z80/supply/main-board/software/pawn/doc/images/supply.png

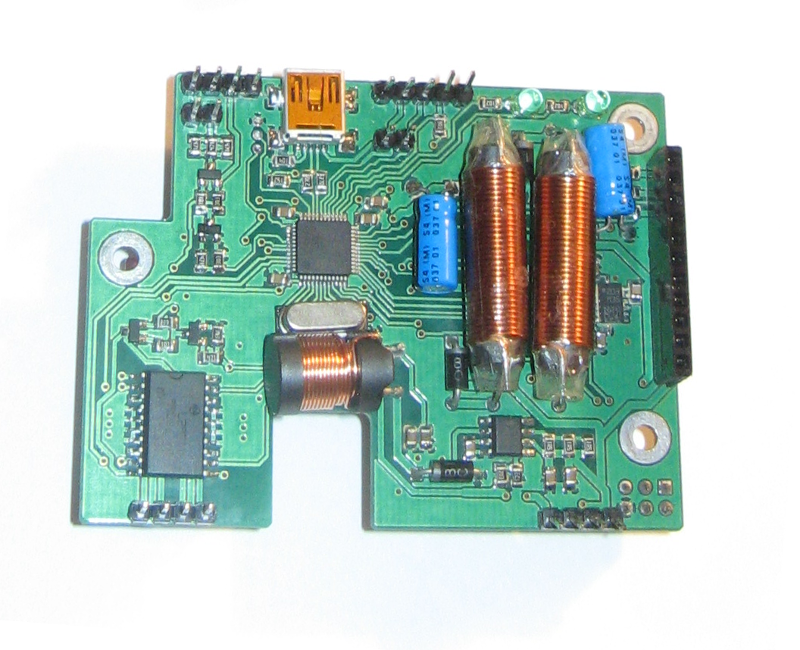
main-board/software/pawn/doc/images/supply.png
