z80/supply/docs/movie_plan.odt

Movie plan.

1. Standalone board introduction.
  1. Overall view.
  2. Explain feature with scripting.
  3. Explain it can work standalone, with computer connected and with RPi connected. Emphasize that it is step to the future detailed explanation. Probably show a stack with RPi and emphasize that it can not only execute it's commands but provide RPi with regulated power. Explain about RPi form factor and cutouts necessary on the board and RPi sockets for which those cutouts are made.
  4. List board interfaces.
    1. USB 1.4.2. Serial. 1.4.3. I2C bus master interface.
    2. I2C slave device. And these two are different and totally independent.
  5. List board peripherials.
    1. High speed microcontroller capable to run up to 72MHz.
    2. 3 voltage converters. Emphasize: these are converters – not regulators. E.i. efficiency is very high. It is proven: board is cold at currents up to 3A.
      1. Constant for 3.3V for feeding internals and has output to provide with stabilized current externally connected devices (if any).
      2. Fully controllable step down converter.
        1. On/off.
        2. Output voltage.
        3. Input current.
      3. Fully controllable step up converter.
        1. On/off.
        2. Output voltage.
        3. Input current.
        4. Minimum input voltage. Important for solar panels.

1.5.3. Motor controller with protective diodes. 4 half bridges. Capable to drive 4 unidirectional DC, 2 bidirectional DC or stepper motor. 600mA continuous current, 1200mA short time current.

1.5.4. LED driver circuit for powering illuminating LED with current of about 100mA.

1.5.5. Analog thermometer with range from -40C to 125C.

1.5.6. Digital accelerometer.

1.5.7. Digital compass.

1.5.8. Digital thermometer.

1.5.9. Trigger button port. Board can change it's behavior in accordance with button clicks.

1.5.10. Power output port. At this port there are all voltages available.

2. Extension boards. If base board functionality isn't enough. One or a few addon boards could be stacked on primary board.

2.1. Content of addon board.

2.1.1. 8 PWM servo compatible output ports. Show servo test in action.

2.1.2. 8 motor controller outputs. Suitable for 8 inidirectional DC motors, 4 bidirectional or 2 stepper motors control.

2.1.3. 8 digital inputs. Like user buttons or digital (on/off state) sensors control.

2.1.4. 8 analog ADC inputs with range from 0V to 3.3V.

2.2. Emphasize that functionality could be multiplied by adding as many addon boards as necessary.

2.3. Demonstrate stacking of a few addon boards on a primary one.

3. Powering the board.

3.1. Powering though step down input. Voltage should be not smaller then 3.3V.

3.2. Powering through step up input. Board can increase input voltage first.

3.3. Powering through USB port. It is the same as through step up port. But here is hardware current limiting circuit. And a switch which actually conducts current from USB socket to board internals.

4. Connecting with a computer.

4.1. Connection through USB socket. Show a connection and explain that it can get power from USB bus. But if high current applications is required a battery is required. Advantage is that the board can charge the battery taring power from USB and increasing voltage using step up configurable converter.

4.2. Connection through RPi extension socket. Explain that in this case communication goes through I2C bus. For the board it is I2C slave mode.

5. Board programming.

5.1. Introduce scripting approach. Emphasize that the board can work alone without a computer. It event can turn computer on and off and can be a power supply for an RPi computer.

5.2. Show an example of blinky script.

5.3. Explain 128kB FLASH and 20kB RAM. But didn't ever occupy more then 2kB FLASH by the moment.

5.3. Script compilation.

5.4. Script upload to the board.

5.5. Script execution and 5 sec delay for an ability to reprogram the board in the case of a fail script.

5.6. Explain board communication. No difference between USB and I2C from the point of view to the interface.

5.7. If coupled with a computer script is in charge for commands interpreting on board side. And user program on the other side.

5.8. Python modules and C++ library with totally identical API for programming communication between the board and a computer.

6. Example board to computer communication.

6.1. Show installation assembling of the board, addon board, two servos and a camera.

6.2. Demonstrate rotatable Web camera example video.

7. Example RPi with the board.

7.1. Show stack assembling.

7.2. Explain the ability of the board to be Rpi power supply and turn it on by a schedule or by button click.

7.3. Assemble an installation with chassis and camera.

7.4. Demonstrate robot video.

7. Example pure RPi power supply.

7.4. Assemble stack and explain where power comes from.

7.5. Attach user button and explain the feature with powering on.

7.6. Show in video how it works.
