z80/supply/main-board/software/pawn/doc/images/2_addons_on_supply_on_pi.png

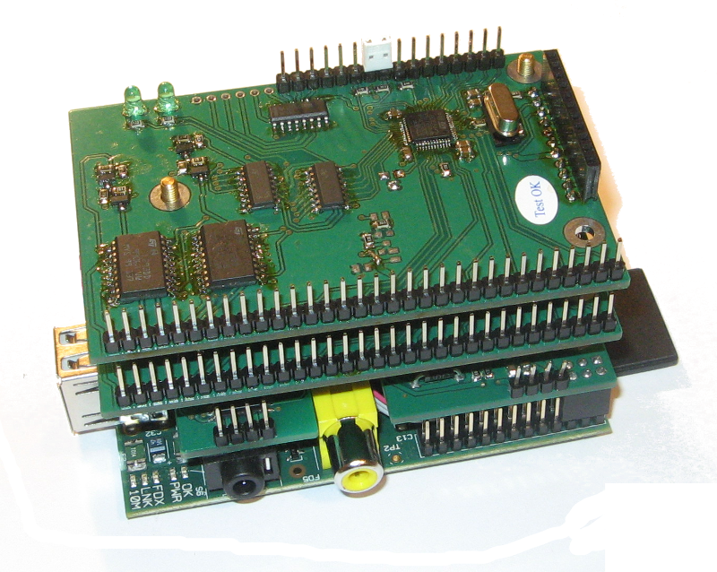
main-board/software/pawn/doc/images/2_addons_on_supply_on_pi.png
