z80/supply/main-board/software/pawn/doc/images/addon.png

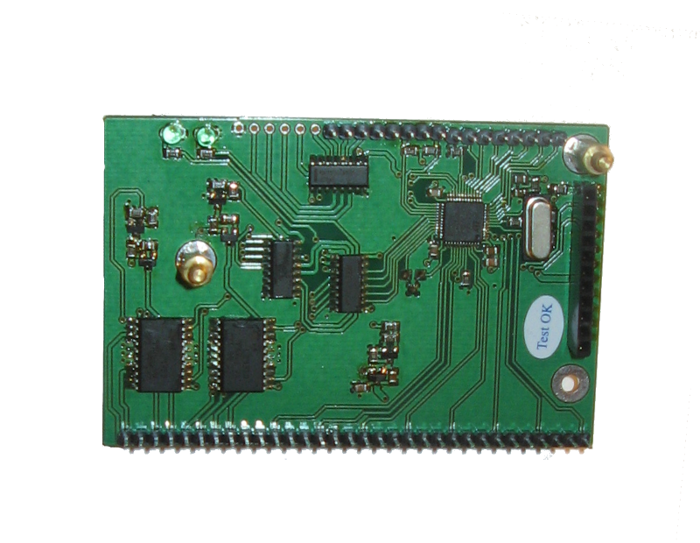
main-board/software/pawn/doc/images/addon.png
