z80/supply/main-board/software/pawn/doc/images/addon_desc.png

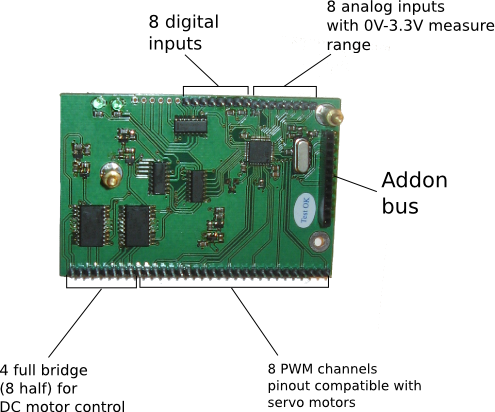
main-board/software/pawn/doc/images/addon_desc.png
