z80/supply/main-board/software/pawn/doc/images/addon_on_supply_on_pi.png

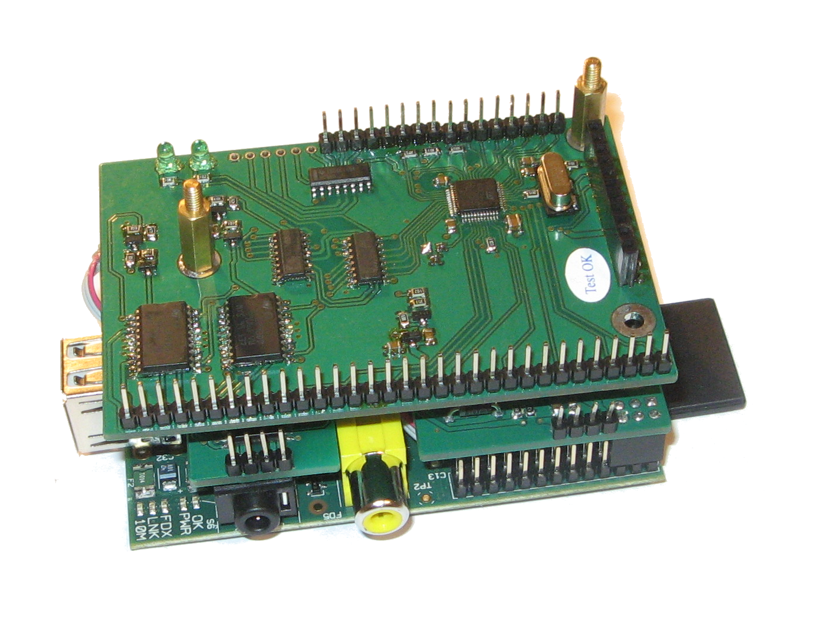
main-board/software/pawn/doc/images/addon_on_supply_on_pi.png
