z80/supply/main-board/software/pawn/doc/images/gui.png

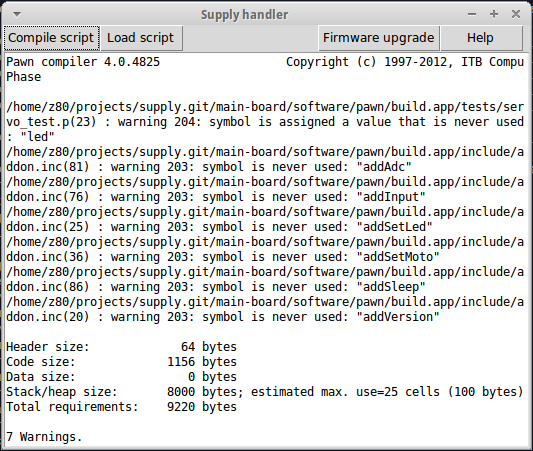
main-board/software/pawn/doc/images/gui.png
