z80/supply/main-board/software/pawn/doc/images/supply_desc.png

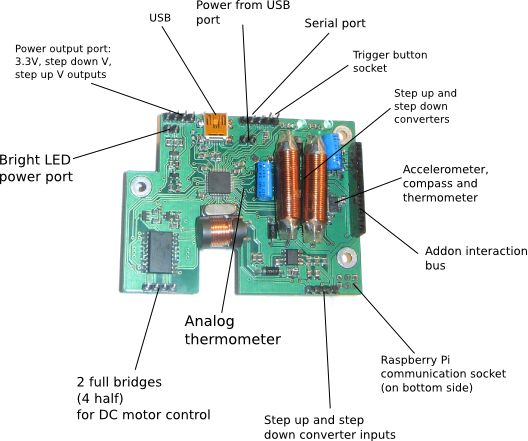
main-board/software/pawn/doc/images/supply_desc.png
