z80/supply/main-board/software/pawn/doc/images/supply_on_pi.png

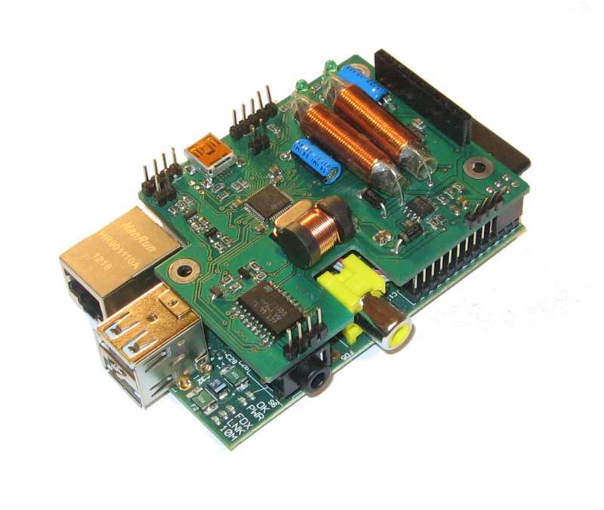
main-board/software/pawn/doc/images/supply_on_pi.png
