z80/supply/docs/bom.ods

Sheet: supply
Description, package | id | cnt | price
mcu, tqfp48 | stm32f103c8t6 | 1 | 200
quartz, 8MHz |  | 1 | 30
schotkey | 1n5819 | 3
opamp | ad8607
inductance for mcu, sumida | RCH114NP-101KB | 1
inductance for bust, buck |  | 2
accelerometer/compass, lga14 | lsm303dlhc | 1
Mosfet-P, sot23 | IRLML2244 | 2
Mosfet-p, sot223 | IRLML2244 | 1
Mosfet-N, sot223 | IRLML2502 | 1
tc1047A, temperature sensor, sot23 |  | 1
ncp3063 |  | 1
L293D driver |  | 1
mini USB-B |  | 1

Sheet: addon
Description, package | id | cnt | price
Posfet-P, sot23 | IRLML2244 | 3
stm32, lqft48 |  | 1
quartz, 8MHz |  | 1
L293D |  | 2
74HC595 |  | 2
74HC165 |  | 1
