z80/supply/(list of files, cad)

Other CAD files:
main-board-2/firmware/chibios/demos/STM8L-STM8L152-DISCOVERY-STVD/cosmic/cosmic.stp
main-board-2/firmware/chibios/demos/STM8L-STM8L152-DISCOVERY-STVD/raisonance/raisonance.stp
main-board-2/firmware/chibios/demos/STM8S-STM8S105-DISCOVERY-STVD/cosmic/cosmic.stp
main-board-2/firmware/chibios/demos/STM8S-STM8S105-DISCOVERY-STVD/raisonance/raisonance.stp
main-board-2/firmware/chibios/testhal/STM8S/SPI/cosmic/cosmic.stp
main-board-2/firmware/chibios/testhal/STM8S/SPI/raisonance/raisonance.stp
