z80/supply/docs/todo.odt

Found errors.

1. Main board: solar input comes directly to boost circuit without passing OpAmp. E.i. charging current is not measured at the moment.

2. USB power goes to nowhere as “boost+” network is not connected to anything. But it goes through OpAmp and measured.

3. Capacitors must be at least 1000uF to prevent Raspberry and WiFi from hanging up. Event with such capacitors the system hangs up after attempt to work with servos. So it is necessary to filter servo power consumption.

4. Inductors (to the right) and capacitors (up) must be shifter in order to free enough room for 1000uF capacitors.

5. Some sort of current limiting circuit MUST be implemented as 1000uF capacitors are used for power filtering. Now made it as a little separate board.

6. Make at least 2 buck inputs, 2 boost inputs and 4 ground. It is because designed current limit per pin is 1A but system consumption is much more.

7. Make holes for cross board sockets CSLS compatible.

8. Displace accelerometer and electrolytic capacitors to leave some room for LEDs. As now they overlap.

9. Rotate LED power socket 90 degrees to the right.

10. Make normal programming sockets. E.i. Attachable with step size 2.54mm.

11. Make power and motor sockets “klemma” sockets!!! This is absolutely necessary!

12. One more power socket (at least holes for delivering power) on addon board.

13. Ability to FLASH addon board using serial bootloader. E.i. BOOT0 to 3.3V jumper or holes for that jumper. And explicitly show three pins for attaching serial cable to.

14. Make I2C address savable to FLASH memory on addon boards. Add command to set new I2C adress respectively.

To do list related to regular firmware.

1. ~~Split build into two projects with common source folder but different config files.~~

2. ~~Make USB support and clock frequency different in these projects.~~

3. ~~Implement buck/boost converters with current limiting and boost power source lower voltage limit.~~

5. ~~Implement temperature, voltages and currents measure.~~

6. ~~Implement LED controls.~~

7. ~~Implement motor controls.~~

6. ~~Implement low power modes.~~ It is implemented by default in chibios.

7. ~~Implement Pawn machine with uint8_t state array accessible with both USB and I2C slave.~~

7.1. ~~Add converter parameters setup, all measures (I, V, T) to Pawn.~~

~~7.2. Make Pawn header file with native functions list.~~

7.3. Adjust library responsible for USB communication. It should write compiled Pawn script with maximum speed. It should have access to Pawn state array. And it should be able to do the same through I2C slave.

7.4. Make Pawn compilation support, make some sort of command line..... (may be, don't know yet).

8. ~~Implement I2C master with RAW functionality. E.i. write and read.~~

9. Make GUI for firmware upgrade and Pawn compilation.

10. Implement interface library support in Python (??? may be).

11. ~~Implement UART support.~~

12. Implement UART support in Pawn.

13. Add UART support to Pawn native functions header file.

To do list related to firmware for addon board.

1. Implement buffers support.

2. Implement power outs support.

3. Implement digital inputs support.

4. Implement ADC support.

5. Implement I2C slave support.

6. Implement 1....4 functionality invocation in I2C slave.

Found errors.

1. “+6V” and “batt+” should be connected. But they are not!

2. Make optional servo charge through resistor to prevent servo jumps at power up.

3. Make P-mosfet on/off as it is now but without any slow start because it turned out to not working as expected! Anyway current is much higher then desired.

4. Servos hang up Raspberry. It must be it is due to high current consumption. It might be it would be nice to place an inductor there to filter incoming voltage. It doesn't help.

5. Make all sockets to stay close to board edge.
