z80/supply/addon-acc/electric/scheme/addon-acc.kicad_pcb

## KiCad design addon-acc/electric/scheme/addon-acc.kicad_pcb (2013-12-23)

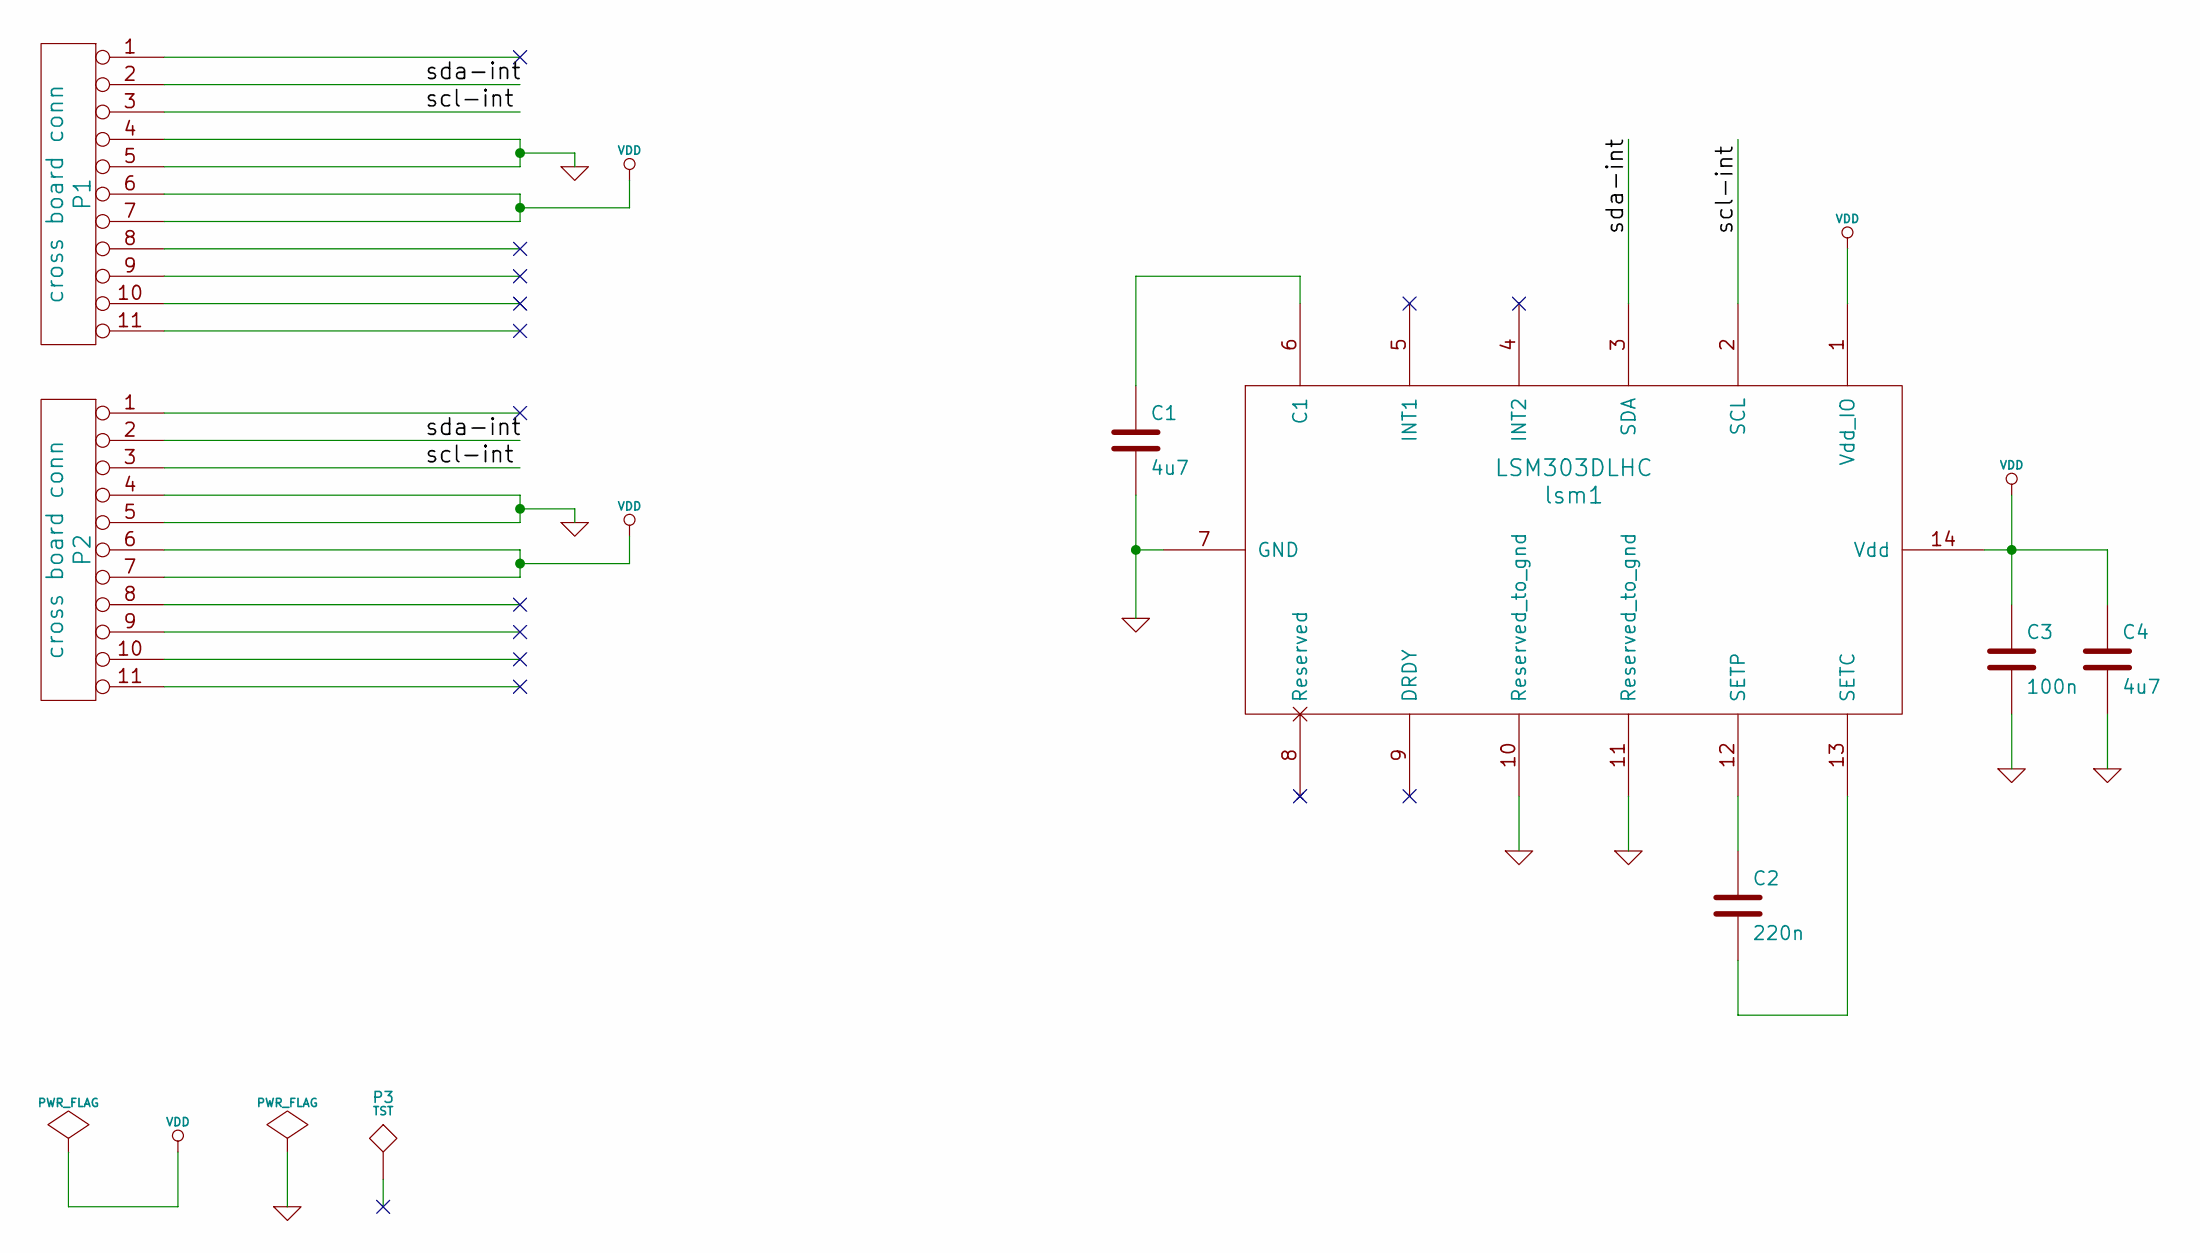
[picture p13: schematic addon-acc.sch]

Parts:
C1, C4: 4u7
C2: 220n
C3: 100n
P1, P2: cross board conn
P3: TST
lsm1: LSM303DLHC

Connections:
/scl-int: P1.3, P2.3, lsm1.2 (SCL)
/sda-int: P1.2, P2.2, lsm1.3 (SDA)
GND: C1.2, C3.2, C4.2, P1.4, P1.5, P2.4, P2.5, lsm1.7 (GND), lsm1.10 (Reserved_to_gnd), lsm1.11 (Reserved_to_gnd)
unnamed: C2.1, lsm1.12 (SETP)
unnamed: C1.1, lsm1.6 (C1)
unnamed: C2.2, lsm1.13 (SETC)
VDD: C3.1, C4.1, P1.6, P1.7, P2.6, P2.7, lsm1.1 (Vdd_IO), lsm1.14 (Vdd)

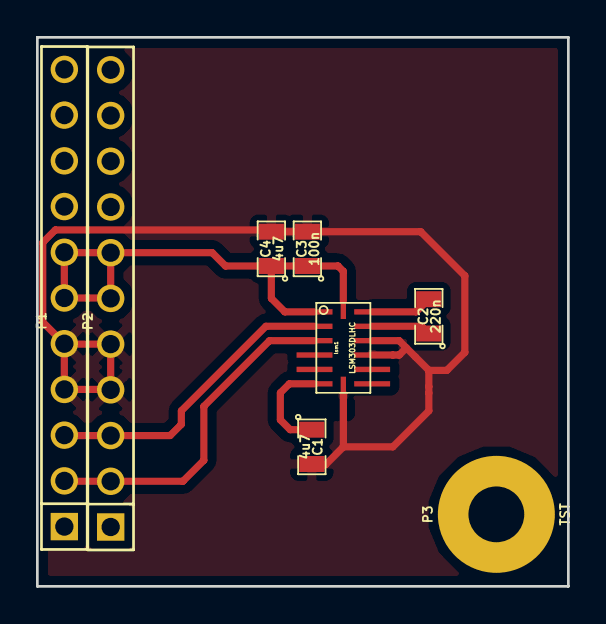
[picture p14: board addon-acc.kicad_pcb from above]

Board: 2 copper layers, 29.5 x 30.5 mm, 8 parts (0 on the bottom side), 7 nets.
