z80/supply/addon-gpio/electric/scheme/addon-gpio.kicad_pcb

## KiCad design addon-gpio/electric/scheme/addon-gpio.kicad_pcb (2013-12-23)

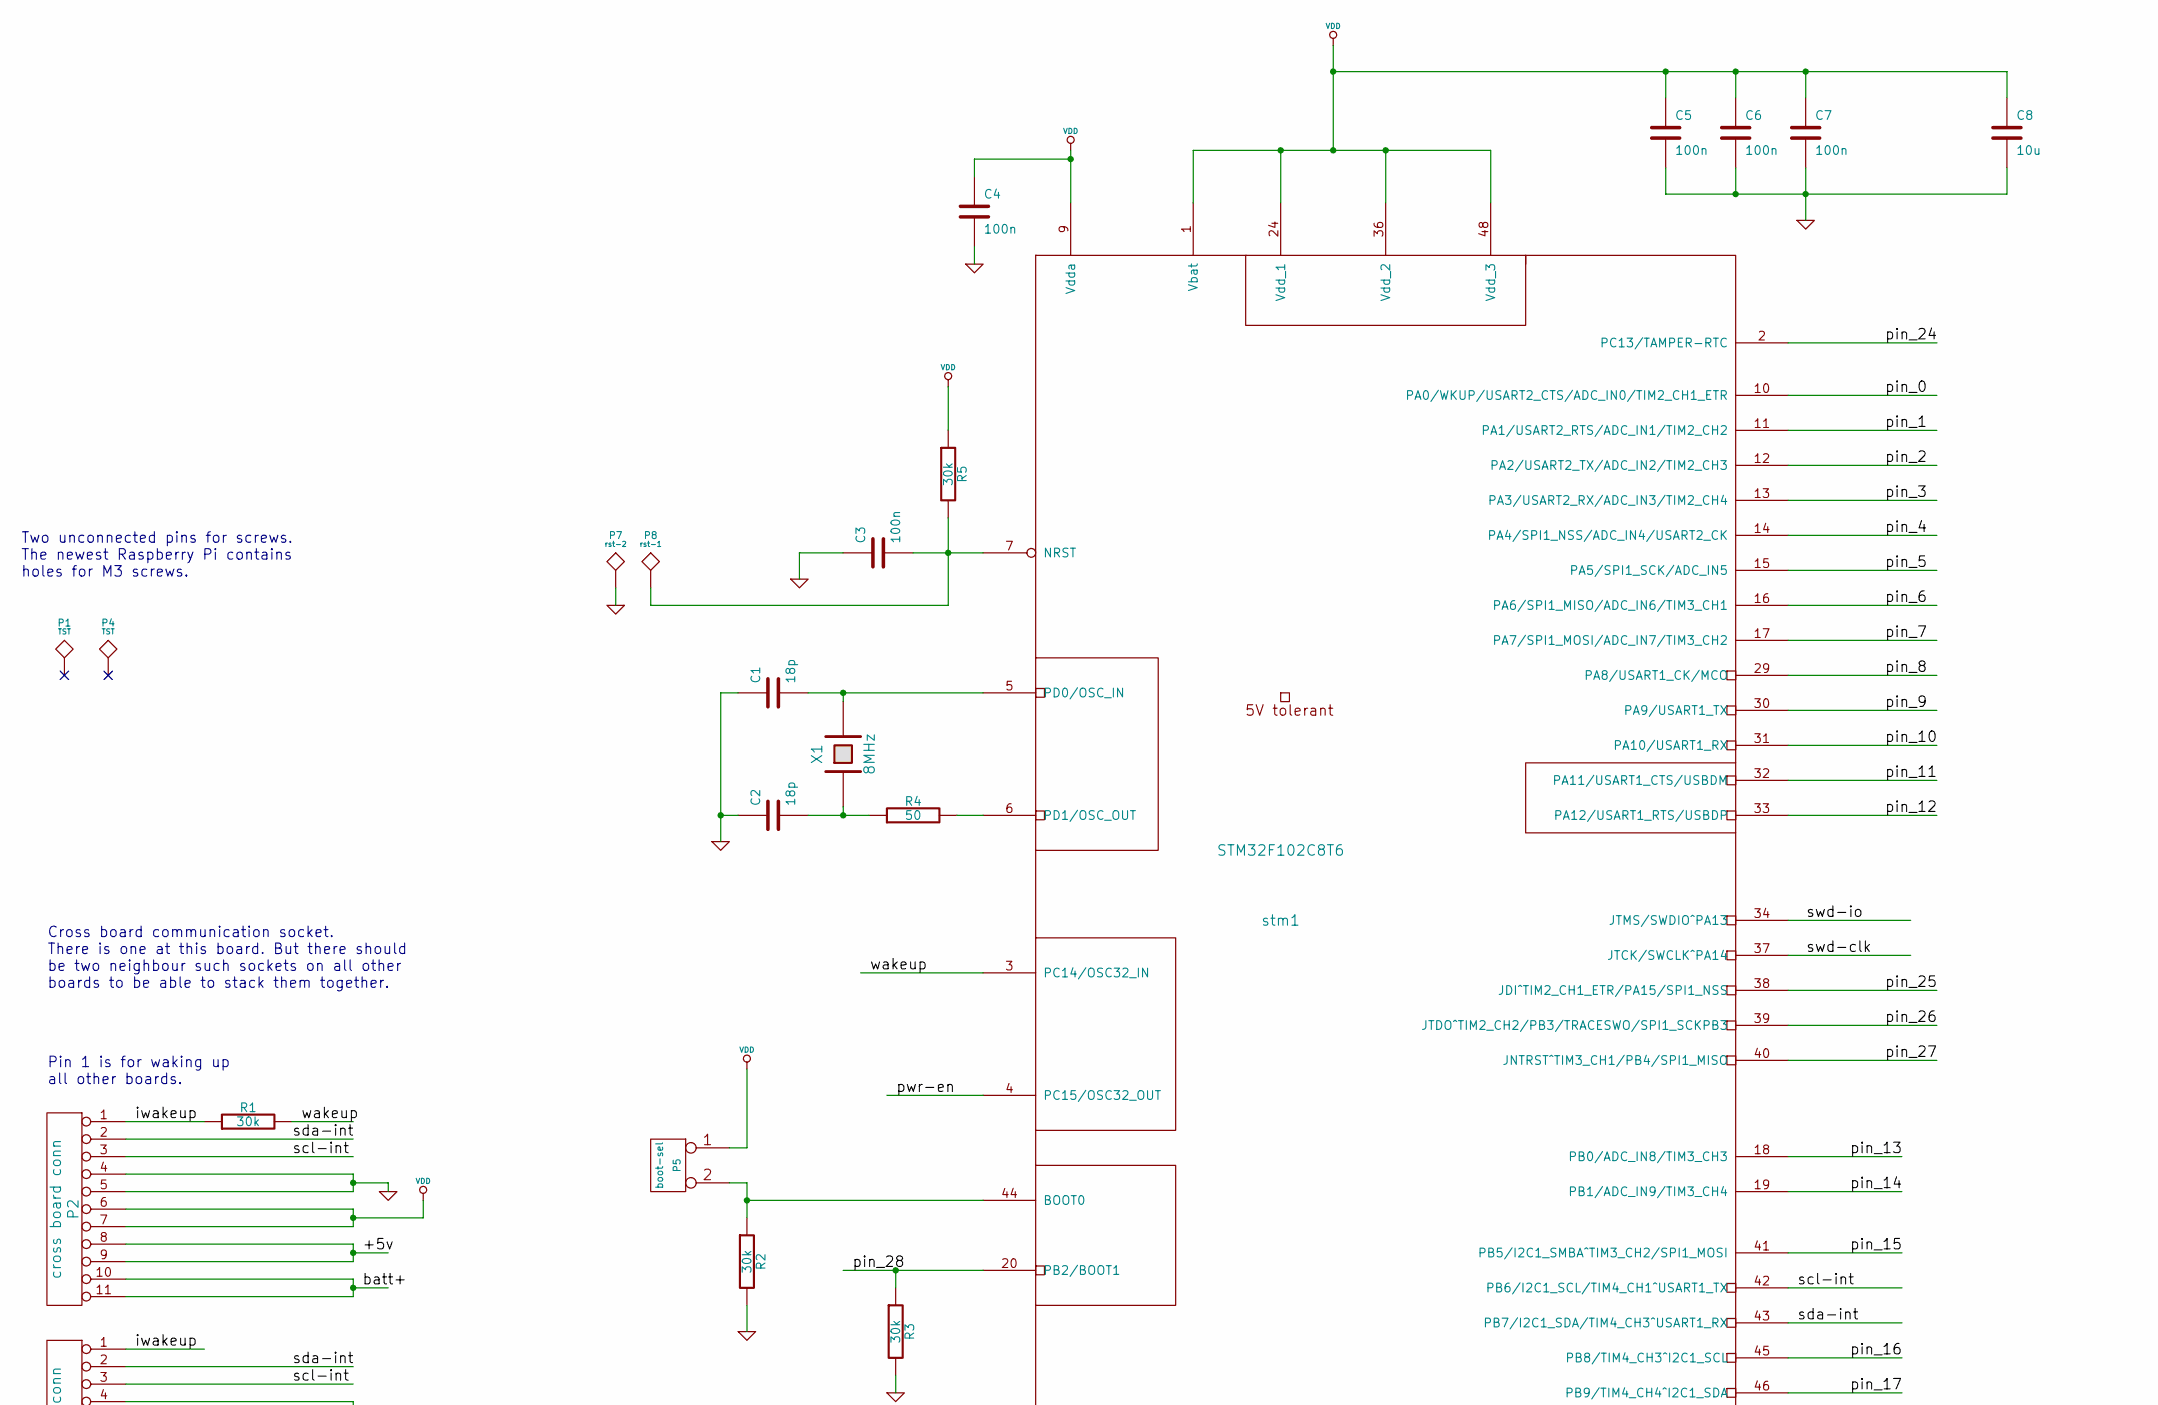
[picture p15: schematic addon-gpio.sch, part in row 1, column 1]

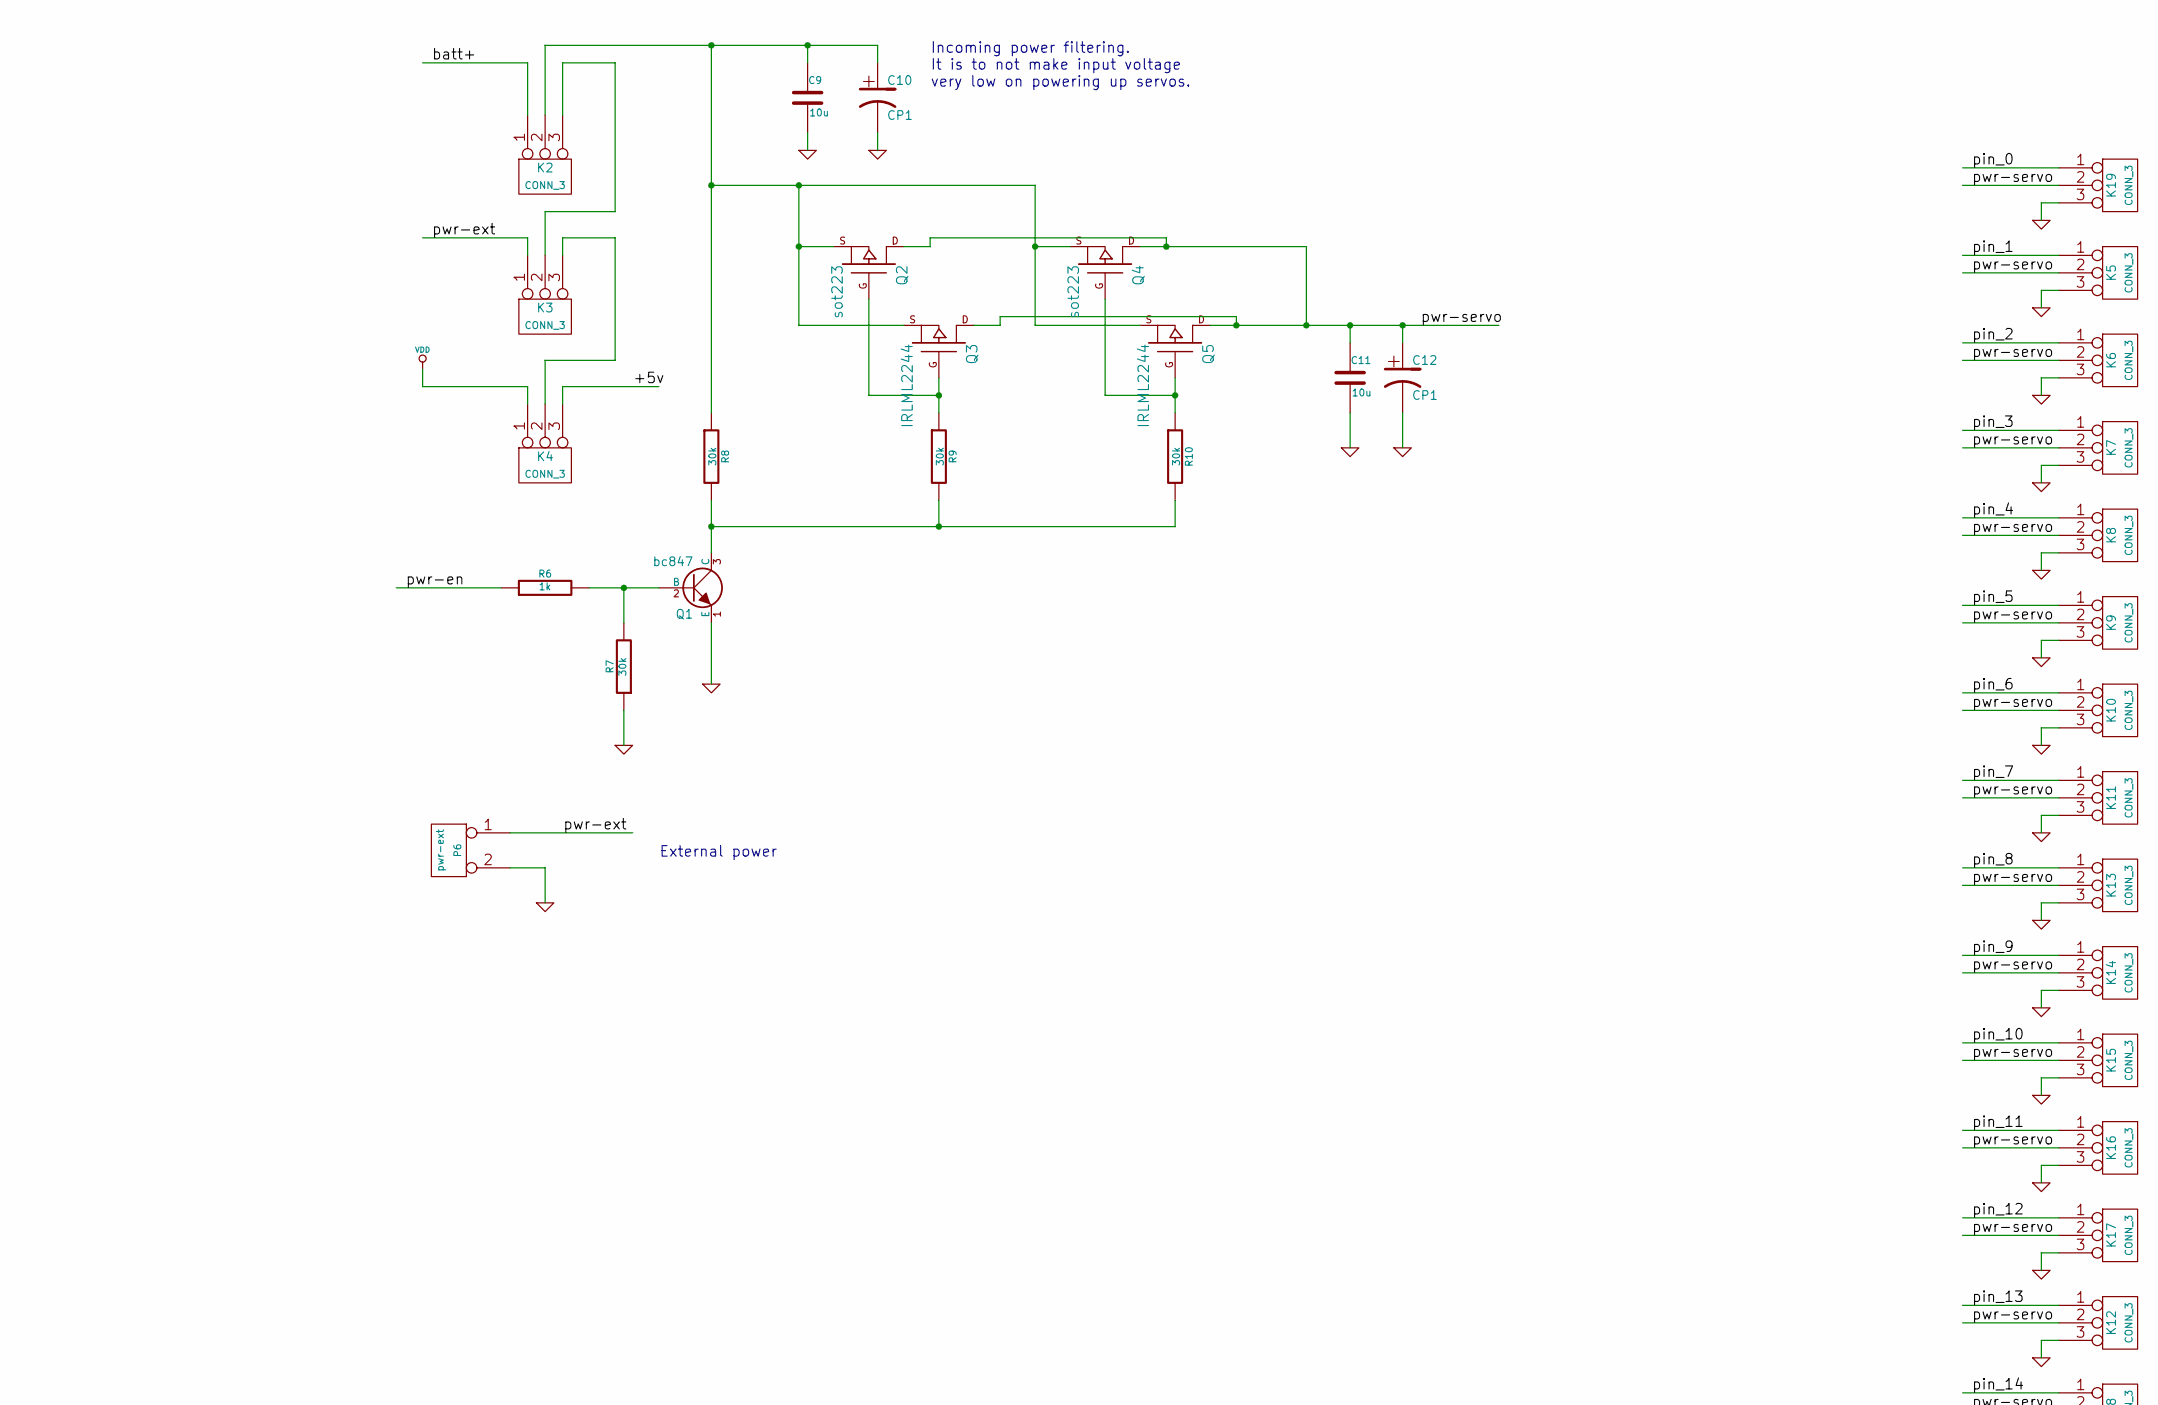
[picture p16: schematic addon-gpio.sch, part in row 1, column 2]

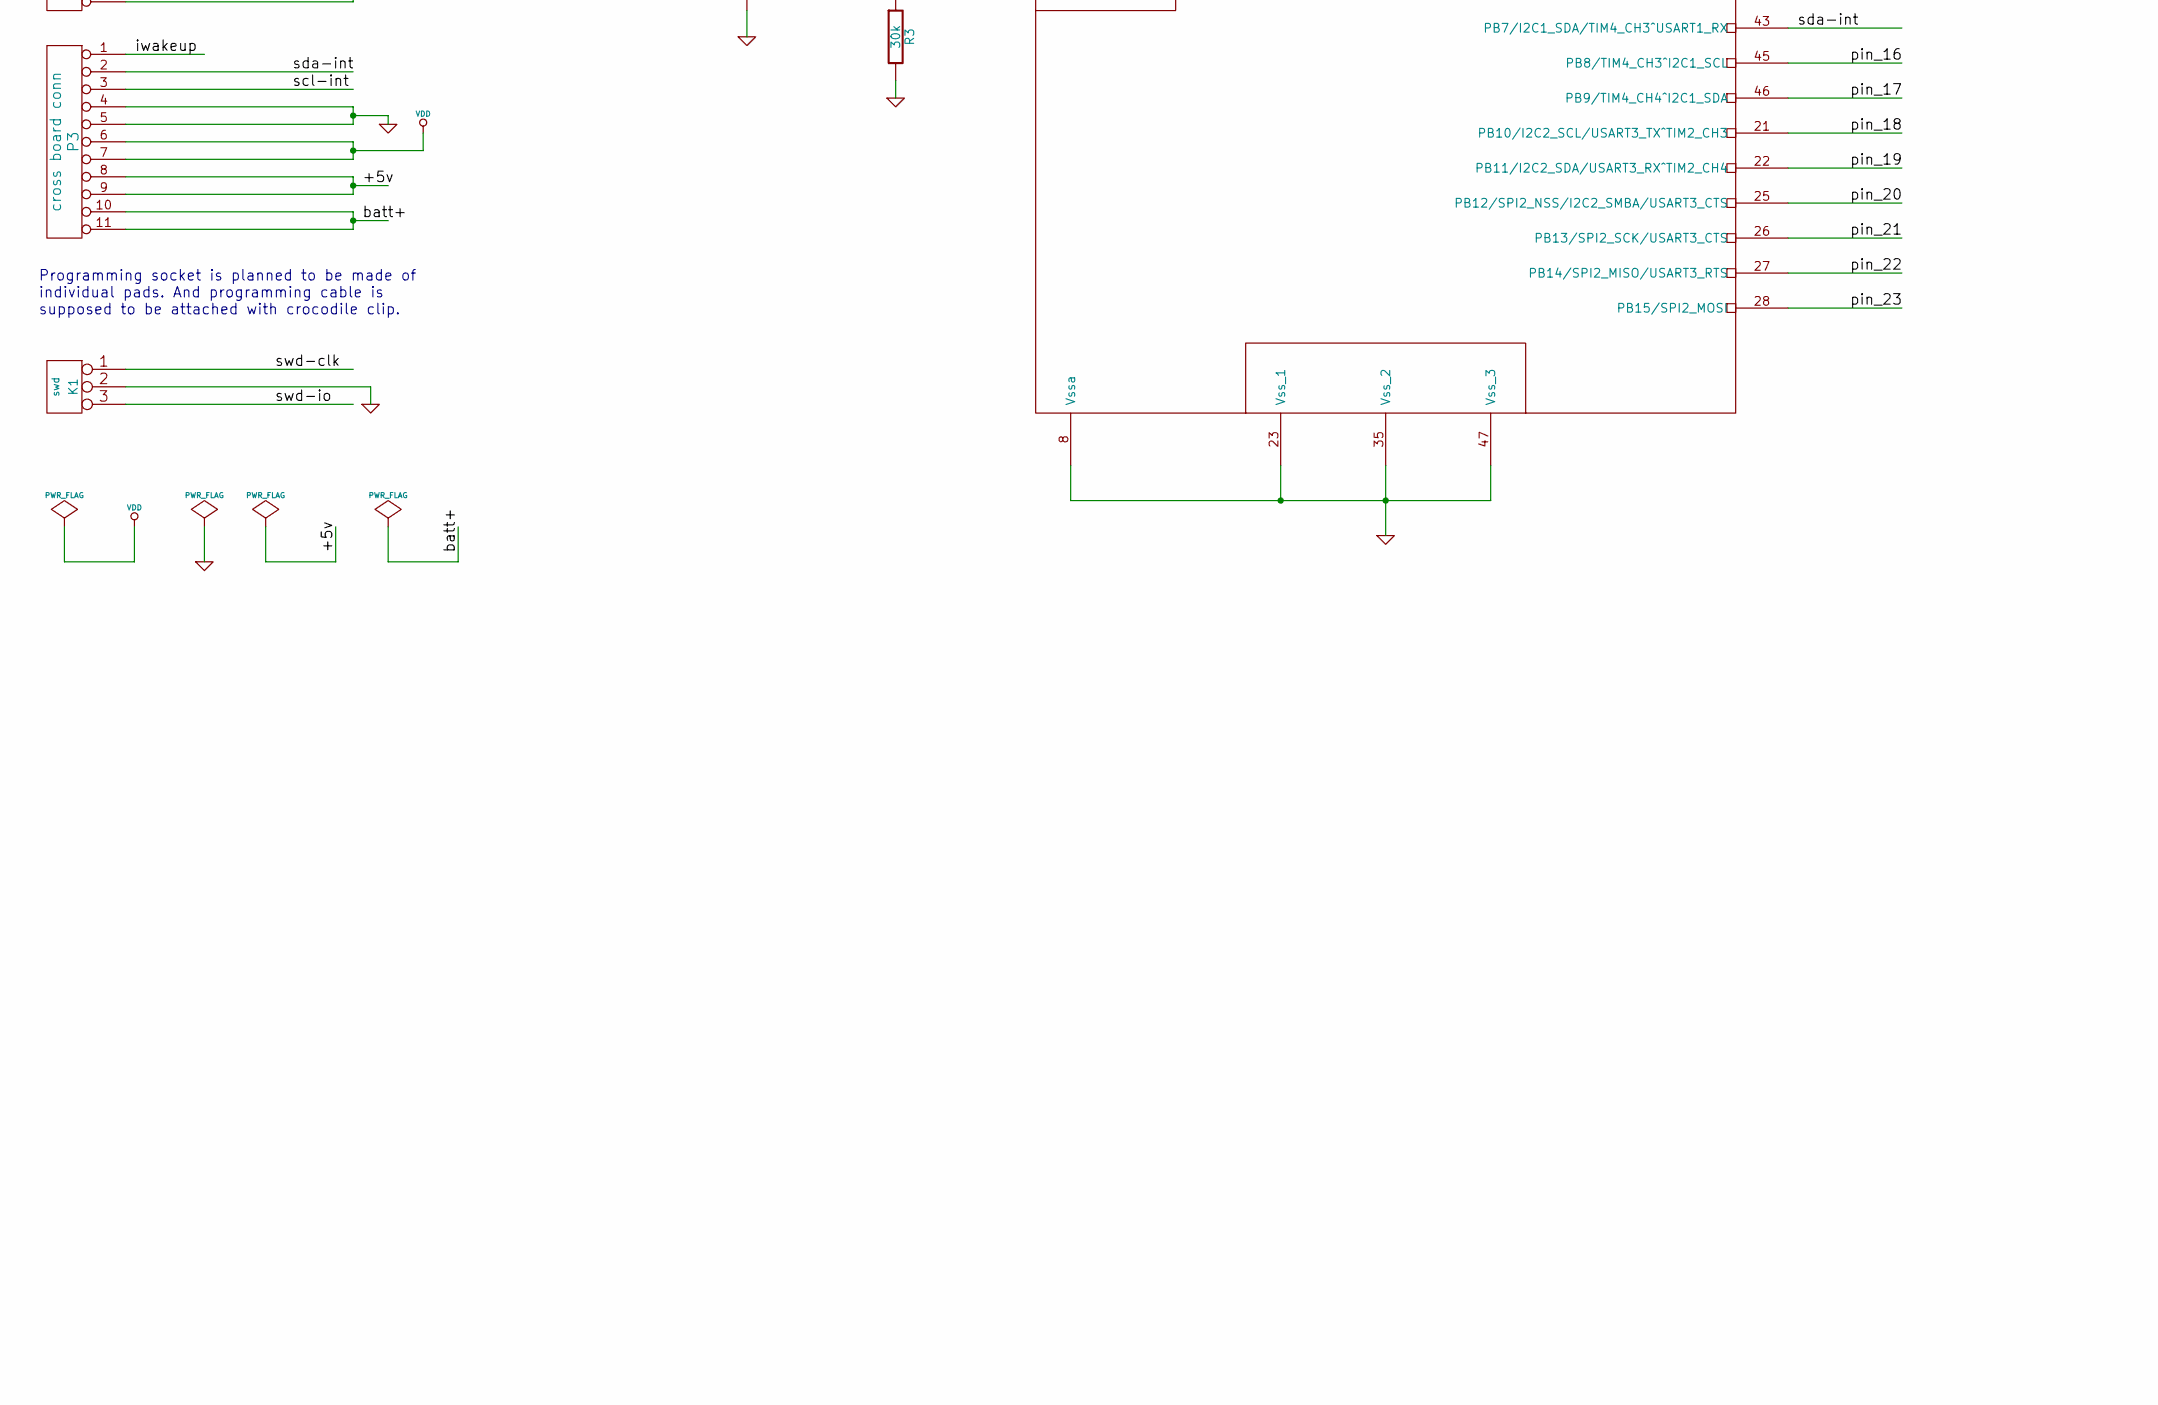
[picture p17: schematic addon-gpio.sch, part in row 2, column 1]

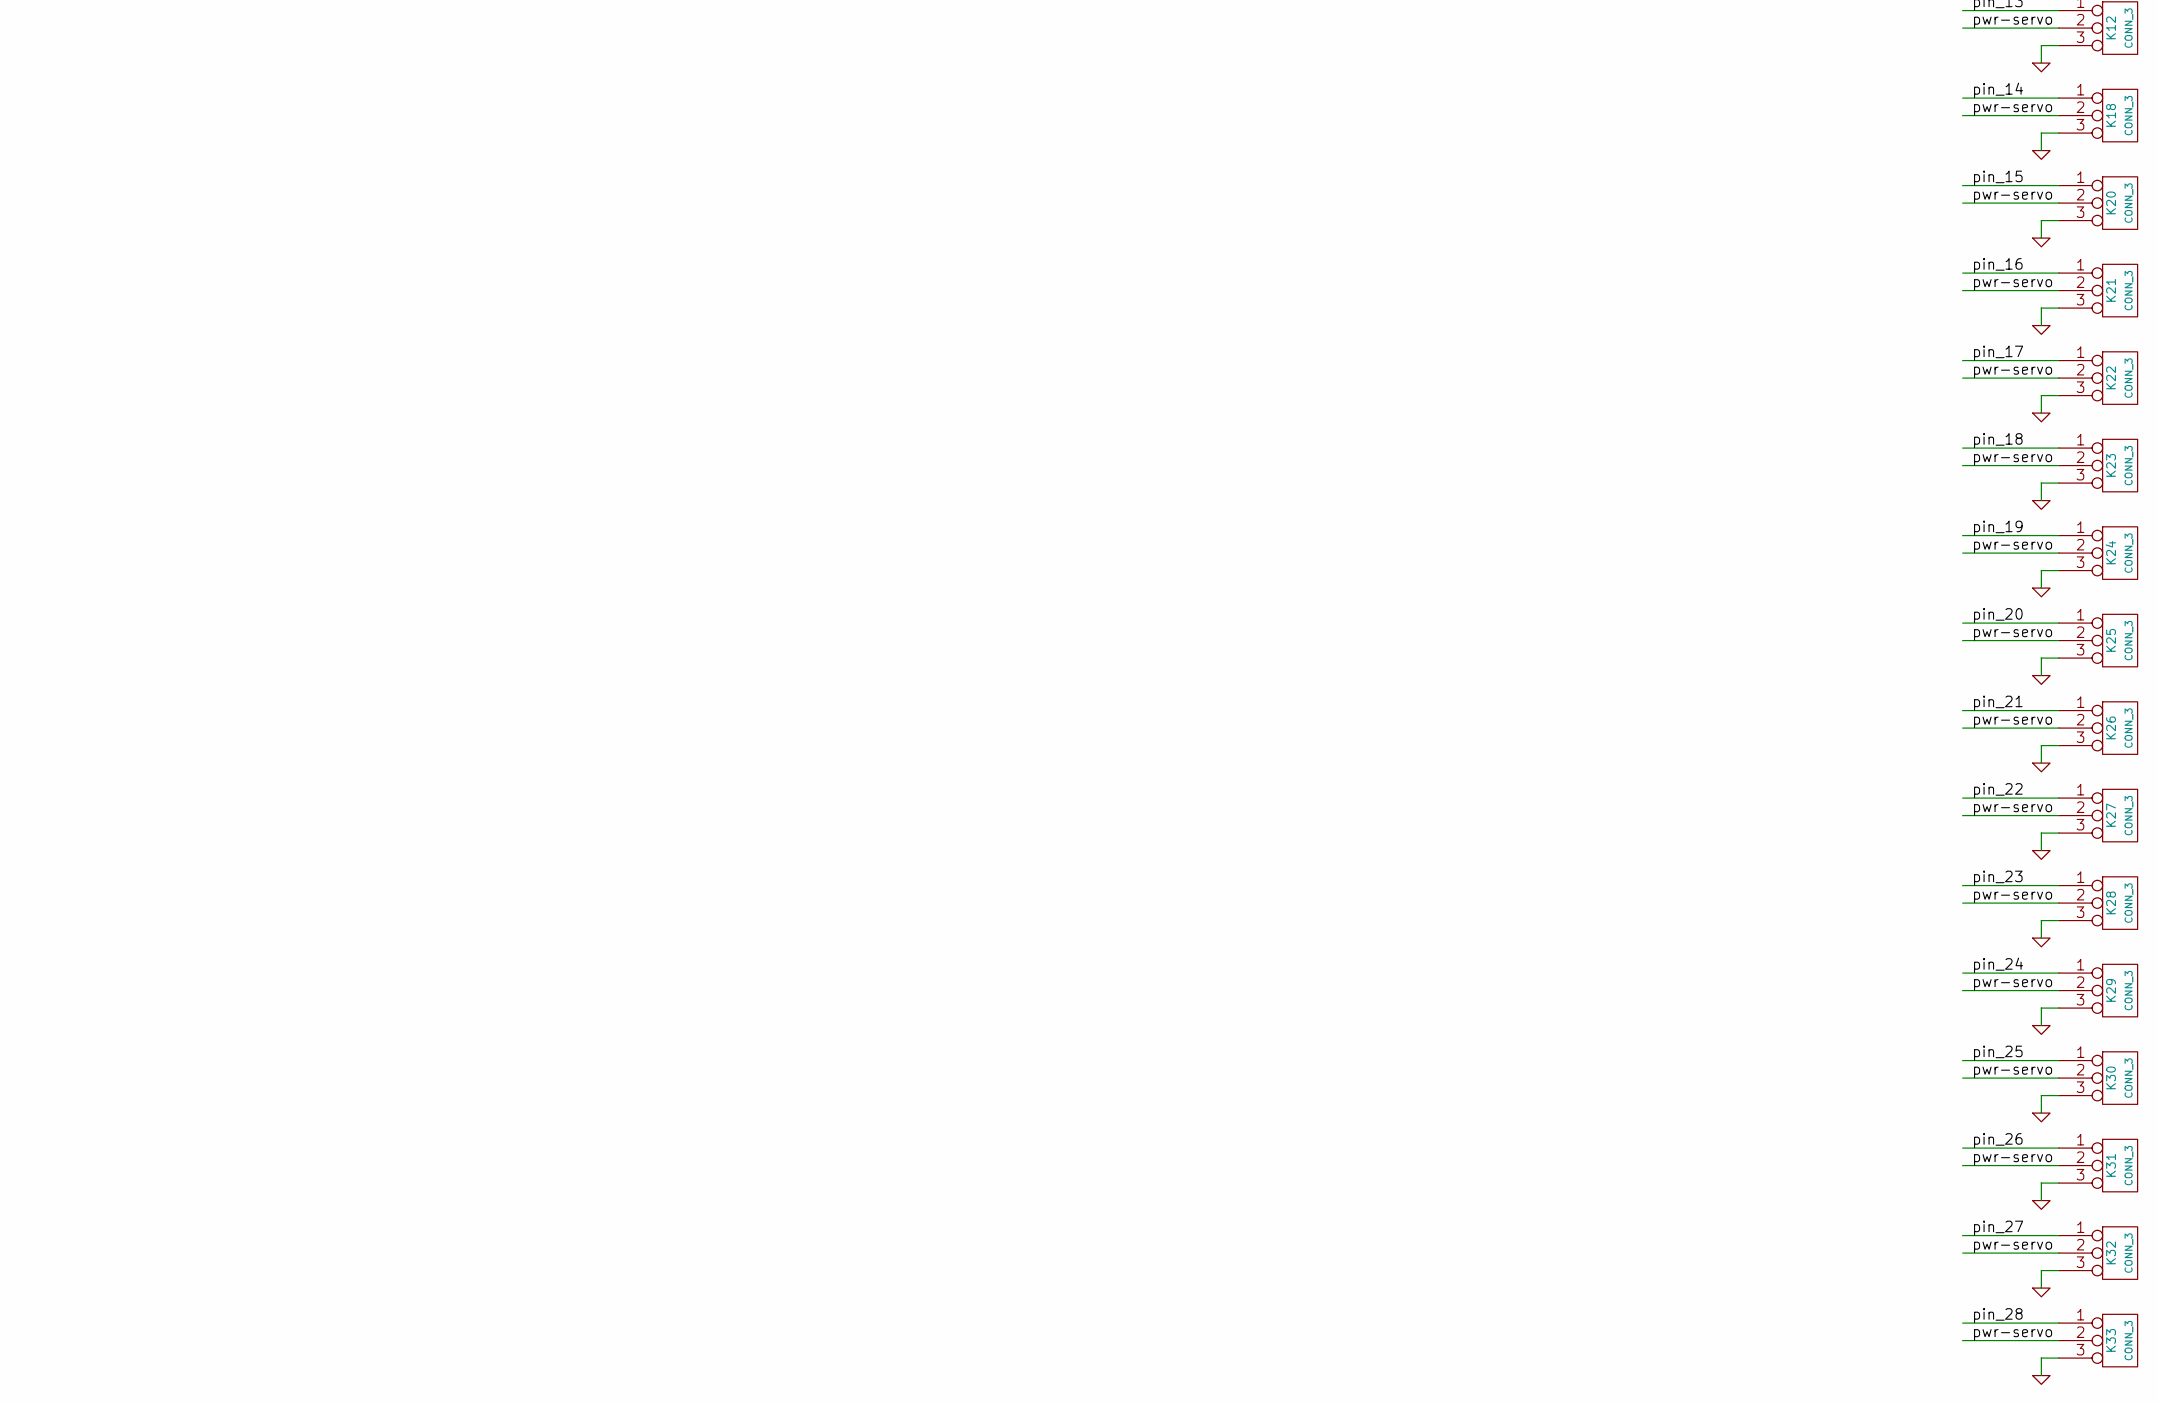
[picture p18: schematic addon-gpio.sch, part in row 2, column 2]

Parts:
C1, C2: 18p
C3, C4, C5, C6, C7: 100n
C8: 10u
C9, C11: 10u
C10, C12: CP1
K1: swd
K2, K3, K4, K5, K6, K7, K8, K9, K10, K11, K12, K13, K14, K15, K16, K17, K18, K19, K20, K21, K22, K23, K24, K25, K26, K27, K28, K29, K30, K31, K32, K33: CONN_3
P1, P4: TST
P2, P3: cross board conn
P5: boot-sel
P6: pwr-ext
P7: rst-2
P8: rst-1
Q1: bc847
Q2, Q4: sot223
Q3, Q5: IRLML2244
R1, R2, R3, R5: 30k
R4: 50
R6: 1k
R7, R8, R9, R10: 30k
X1: 8MHz
stm1: STM32F102C8T6

Connections:
/+5v: K4.3, P2.8, P2.9, P3.8, P3.9
/batt+: K2.1, P2.10, P2.11, P3.10, P3.11
/iwakeup: P2.1, P3.1, R1.1
/pin_0: K19.1, stm1.10 (PA0/WKUP/USART2_CTS/ADC_IN0/TIM2_CH1_ETR)
/pin_1: K5.1, stm1.11 (PA1/USART2_RTS/ADC_IN1/TIM2_CH2)
/pin_2: K6.1, stm1.12 (PA2/USART2_TX/ADC_IN2/TIM2_CH3)
/pin_3: K7.1, stm1.13 (PA3/USART2_RX/ADC_IN3/TIM2_CH4)
/pin_4: K8.1, stm1.14 (PA4/SPI1_NSS/ADC_IN4/USART2_CK)
/pin_5: K9.1, stm1.15 (PA5/SPI1_SCK/ADC_IN5)
/pin_6: K10.1, stm1.16 (PA6/SPI1_MISO/ADC_IN6/TIM3_CH1)
/pin_7: K11.1, stm1.17 (PA7/SPI1_MOSI/ADC_IN7/TIM3_CH2)
/pin_8: K13.1, stm1.29 (PA8/USART1_CK/MCO)
/pin_9: K14.1, stm1.30 (PA9/USART1_TX)
/pin_10: K15.1, stm1.31 (PA10/USART1_RX)
/pin_11: K16.1, stm1.32 (PA11/USART1_CTS/USBDM)
/pin_12: K17.1, stm1.33 (PA12/USART1_RTS/USBDP)
/pin_13: K12.1, stm1.18 (PB0/ADC_IN8/TIM3_CH3)
/pin_14: K18.1, stm1.19 (PB1/ADC_IN9/TIM3_CH4)
/pin_15: K20.1, stm1.41 (PB5/I2C1_SMBA^TIM3_CH2/SPI1_MOSI)
/pin_16: K21.1, stm1.45 (PB8/TIM4_CH3^I2C1_SCL)
/pin_17: K22.1, stm1.46 (PB9/TIM4_CH4^I2C1_SDA)
/pin_18: K23.1, stm1.21 (PB10/I2C2_SCL/USART3_TX^TIM2_CH3)
/pin_19: K24.1, stm1.22 (PB11/I2C2_SDA/USART3_RX^TIM2_CH4)
/pin_20: K25.1, stm1.25 (PB12/SPI2_NSS/I2C2_SMBA/USART3_CTS)
/pin_21: K26.1, stm1.26 (PB13/SPI2_SCK/USART3_CTS)
/pin_22: K27.1, stm1.27 (PB14/SPI2_MISO/USART3_RTS)
/pin_23: K28.1, stm1.28 (PB15/SPI2_MOSI)
/pin_24: K29.1, stm1.2 (PC13/TAMPER-RTC)
/pin_25: K30.1, stm1.38 (JDI^TIM2_CH1_ETR/PA15/SPI1_NSS)
/pin_26: K31.1, stm1.39 (JTDO^TIM2_CH2/PB3/TRACESWO/SPI1_SCKPB3)
/pin_27: K32.1, stm1.40 (JNTRST^TIM3_CH1/PB4/SPI1_MISO)
/pin_28: K33.1, R3.1, stm1.20 (PB2/BOOT1)
/pwr-en: R6.1, stm1.4 (PC15/OSC32_OUT)
/pwr-ext: K3.1, P6.1
/pwr-servo: C11.1, C12.1, K5.2 (PM), K6.2 (PM), K7.2 (PM), K8.2 (PM), K9.2 (PM), K10.2 (PM), K11.2 (PM), K12.2 (PM), K13.2 (PM), K14.2 (PM), K15.2 (PM), K16.2 (PM), K17.2 (PM), K18.2 (PM), K19.2 (PM), K20.2 (PM), K21.2 (PM), K22.2 (PM), K23.2 (PM), K24.2 (PM), K25.2 (PM), K26.2 (PM), K27.2 (PM), K28.2 (PM), K29.2 (PM), K30.2 (PM), K31.2 (PM), K32.2 (PM), K33.2 (PM), Q2.D, Q3.D, Q4.D, Q5.D
/scl-int: P2.3, P3.3, stm1.42 (PB6/I2C1_SCL/TIM4_CH1^USART1_TX)
/sda-int: P2.2, P3.2, stm1.43 (PB7/I2C1_SDA/TIM4_CH3^USART1_RX)
/swd-clk: K1.1, stm1.37 (JTCK/SWCLK^PA14)
/swd-io: K1.3, stm1.34 (JTMS/SWDIO^PA13)
/wakeup: R1.2, stm1.3 (PC14/OSC32_IN)
GND: C1.1, C2.1, C3.1, C4.2, C5.2, C6.2, C7.2, C8.2, C9.2, C10.2, C11.2, C12.2, K1.2 (PM), K5.3, K6.3, K7.3, K8.3, K9.3, K10.3, K11.3, K12.3, K13.3, K14.3, K15.3, K16.3, K17.3, K18.3, K19.3, K20.3, K21.3, K22.3, K23.3, K24.3, K25.3, K26.3, K27.3, K28.3, K29.3, K30.3, K31.3, K32.3, K33.3, P2.4, P2.5, P3.4, P3.5, P6.2 (PM), P7.1, Q1.1 (E), R2.2, R3.2, R7.1, stm1.8 (Vssa), stm1.23 (Vss_1), stm1.35 (Vss_2), stm1.47 (Vss_3)
unnamed: K2.3, K3.2 (PM)
unnamed: K3.3, K4.2 (PM)
unnamed: C3.2, P8.1, R5.2, stm1.7 (NRST)
unnamed: P5.2 (PM), R2.1, stm1.44 (BOOT0)
unnamed: Q2.G, Q3.G, R9.1
unnamed: Q4.G, Q5.G, R10.1
unnamed: R4.2, stm1.6 (PD1/OSC_OUT)
unnamed: C2.2, R4.1, X1.1
unnamed: C1.2, X1.2, stm1.5 (PD0/OSC_IN)
unnamed: Q1.3 (C), R8.2, R9.2, R10.2
unnamed: C9.1, C10.1, K2.2 (PM), Q2.S, Q3.S, Q4.S, Q5.S, R8.1
unnamed: Q1.2 (B), R6.2, R7.2
VDD: C4.1, C5.1, C6.1, C7.1, C8.1, K4.1, P2.6, P2.7, P3.6, P3.7, P5.1, R5.1, stm1.1 (Vbat), stm1.9 (Vdda), stm1.24 (Vdd_1), stm1.36 (Vdd_2), stm1.48 (Vdd_3)

Notes on the sheet:
Programming socket is planned to be made of individual pads. And programming cable is supposed to be attached with crocodile clip.
Cross board communication socket. There is one at this board. But there should be two neighbour such sockets on all other boards to be able to stack them together.
Two unconnected pins for screws. The newest Raspberry Pi contains holes for M3 screws.
Pin 1 is for waking up all other boards.
External power
Incoming power filtering. It is to not make input voltage very low on powering up servos.

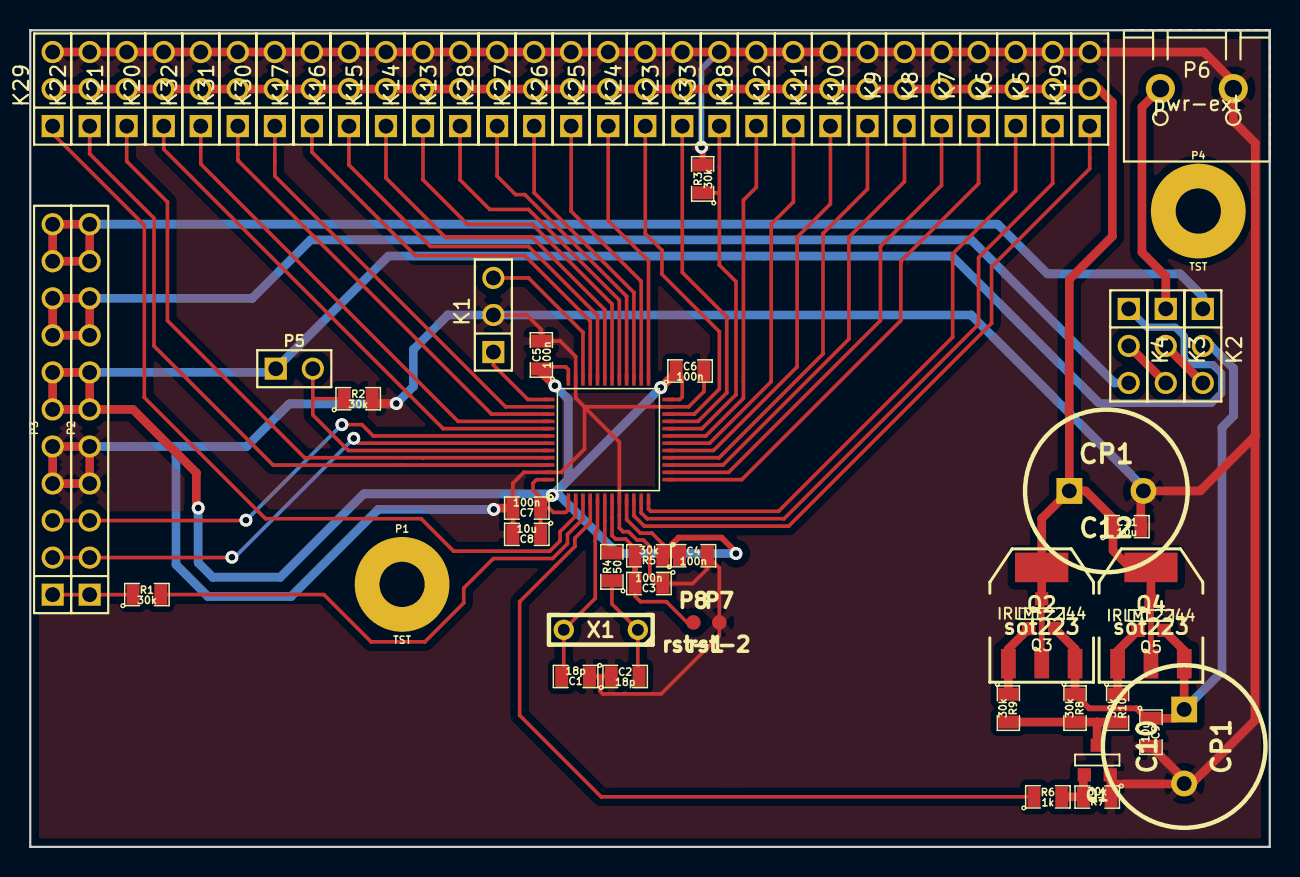
[picture p19: board addon-gpio.kicad_pcb from above]

Board: 2 copper layers, 85.0 x 56.0 mm, 70 parts (0 on the bottom side), 54 nets.
