z80/supply/main-board-2/electric/scheme/main-board-2.kicad_pcb

## KiCad design main-board-2/electric/scheme/main-board-2.kicad_pcb (2013-12-15)

Schematic: main-board-2.sch, Main board 2

Parts:
C1, C6: 54u
C2, C4, C5, C14: 4u7
C3, C9, C10, C11, C12, C13, C15, C16: 100n
C7, C8: 18p
D1, D2: LED
D3, D4, D5, D6, D7, D8, D9, D10: 1n5819
K1: power-switch
K2: usb-power-switch
P1: batt
P3: trigger-btn
P4: CONN_3X2
P7: bootloader
P8: cross board conn
P9, P10: rst
P11: screw-1
P13: screw-2
P14: gpio-big
P15: gpio-small
P16: moto-1
P17: moto-2
Q1, Q3, Q4, Q9, Q10: IRLML2244
Q2, Q5, Q6, Q7, Q8: BC847
Q11: sot223
Q12: bc857
Q13: irlml2244
R1, R3, R6, R10, R22, R23, R26, R27: 1k
R2, R7, R9, R11, R12, R14, R18, R19, R20, R21, R24, R25, R28, R29, R30, R31: 30k
R4: 3k3
R5: 5k1
R8: 3k
R13: 50
R15, R16, R17: 10k
R32, R33: 22
R34: 1k5
R35: 100k
R36, R37, R38, R39: 0.1
R40, R42, R48, R49: 30k
R41, R43, R44, R45: 1k
R46, R47: 3
U1, U3: MY_LM317EMP; SOT-223
U2, U4: MY_LM317T; TO-220
U5: LM293
U6: L298
U7: MINI-USB-B
W1: sc-rpi-5v
W2: sc-addon-5v
W3: sc-addon-3.3
W4, W5, W10: TEST
W6: sc-sense-2
W7: sc-sense-1
W8: sc-moto-2
W9: sc-moto-1
X1: 8MHz
stm1: STM32F102C8T6

Connections:
/+5V: K1.2 (PM), K2.1, Q1.S, Q3.S, Q10.S, R9.2, R20.2, R30.1, W1.1, W2.1, W4.1
/addon-5V: P8.8, P8.9, Q3.D, W2.2
/addon-pwr-en: R22.1, R23.1, R24.2, stm1.26 (PB13/SPI2_SCK/USART3_CTS)
/addon-trigger: R17.2, stm1.19 (PB1/ADC_IN9/TIM3_CH4)
/addon-vdd: P8.6, P8.7, Q4.D, R15.1, R16.1, W3.2
/batt+: C1.1, C2.1, D3.2 (K), D5.2 (K), D7.2 (K), D9.2 (K), K1.3, P1.1, P8.10, P8.11, Q9.S, Q11.S, Q13.D, R28.1, R49.2, U1.3, U2.3, U3.3, U4.3, W5.1, W10.2
/cur-sense-1: R37.1, R39.1, U5.6 (_), U6.1 (current-sensing-A), W7.1
/cur-sense-2: R36.1, R38.1, U5.2 (_), U6.15 (current-sensing-B), W6.1
/d+: R33.1, stm1.33 (PA12/USART1_RTS/USBDP)
/d-: R32.1, stm1.32 (PA11/USART1_CTS/USBDM)
/gpio-1: P14.5, stm1.25 (PB12/SPI2_NSS/I2C2_SMBA/USART3_CTS)
/gpio-2: P14.11, stm1.18 (PB0/ADC_IN8/TIM3_CH3)
/gpio-3: P14.17, stm1.15 (PA5/SPI1_SCK/ADC_IN5)
/gpio-4: P14.23, stm1.13 (PA3/USART2_RX/ADC_IN3/TIM2_CH4)
/gpio-5: P14.6, stm1.27 (PB14/SPI2_MISO/USART3_RTS)
/gpio-6: P14.12, stm1.17 (PA7/SPI1_MOSI/ADC_IN7/TIM3_CH2)
/gpio-7: P14.18, stm1.16 (PA6/SPI1_MISO/ADC_IN6/TIM3_CH1)
/gpio-8: P14.24, stm1.14 (PA4/SPI1_NSS/ADC_IN4/USART2_CK)
/gpio-9: P15.1, stm1.12 (PA2/USART2_TX/ADC_IN2/TIM2_CH3)
/in-moto1: U6.5 (input-1), stm1.11 (PA1/USART2_RTS/ADC_IN1/TIM2_CH2)
/in-moto2: U6.7 (input-2), stm1.10 (PA0/WKUP/USART2_CTS/ADC_IN0/TIM2_CH1_ETR)
/in-moto3: U6.10 (input-3), stm1.3 (PC14/OSC32_IN)
/in-moto4: U6.12 (input-4), stm1.4 (PC15/OSC32_OUT)
/led1: R1.1, stm1.46 (PB9/TIM4_CH4^I2C1_SDA)
/led2: R3.1, stm1.45 (PB8/TIM4_CH3^I2C1_SCL)
/moto-en: R25.2, R26.1, R27.1, R44.1, R45.1, W8.1, W9.1, stm1.2 (PC13/TAMPER-RTC)
/moto-en-1: R45.2, U5.7, U6.6 (enable-A), W9.2
/moto-en-2: R44.2, U5.1, U6.11 (enable-B), W8.2
/out1: D9.1 (A), D10.2 (K), P16.1, U6.2 (output-1)
/out2: D7.1 (A), D8.2 (K), P16.2 (PM), U6.3 (output-2)
/out3: D5.1 (A), D6.2 (K), P17.1, U6.13 (output-3)
/out4: D3.1 (A), D4.2 (K), P17.2 (PM), U6.14 (output-4)
/pwrVs: C15.1, P14.3, P14.4, P14.9, P14.10, P14.15, P14.16, P14.21, P14.22, Q9.D, Q11.D, U6.4 (power_Vs), W5.2
/rpi-pwr-en: R10.1, R11.2, stm1.41 (PB5/I2C1_SMBA^TIM3_CH2/SPI1_MOSI)
/rx: P15.3, stm1.31 (PA10/USART1_RX)
/scl-int: P8.3, R16.2, stm1.21 (PB10/I2C2_SCL/USART3_TX^TIM2_CH3)
/scl-rpi: P4.5, stm1.42 (PB6/I2C1_SCL/TIM4_CH1^USART1_TX)
/sda-int: P8.2, R15.2, stm1.22 (PB11/I2C2_SDA/USART3_RX^TIM2_CH4)
/sda-rpi: P4.3, stm1.43 (PB7/I2C1_SDA/TIM4_CH3^USART1_RX)
/swd-clk: P15.4, stm1.37 (JTCK/SWCLK^PA14)
/swd-io: P15.6, stm1.34 (JTMS/SWDIO^PA13)
/trigger-button: P3.1, R2.1, stm1.29 (PA8/USART1_CK/MCO)
/tx: P15.5, stm1.30 (PA9/USART1_TX)
/usb-connected: R34.2, stm1.28 (PB15/SPI2_MOSI)
/usb-power: K2.2 (PM), U7.1 (VBus)
GND: C1.2, C2.2, C3.2, C4.2, C5.2, C6.2, C7.1, C8.1, C9.1, C10.2, C11.2, C12.2, C13.2, C14.2, C15.2, C16.2, D1.2 (K), D2.2 (K), D4.1 (A), D6.1 (A), D8.1 (A), D10.1 (A), P1.2 (PM), P3.2 (PM), P4.6, P8.4, P8.5, P10.1, P14.1, P14.2, P14.7, P14.8, P14.13, P14.14, P14.19, P14.20, P15.2, Q2.1 (E), Q5.1 (E), Q6.1 (E), Q8.1 (E), R4.2, R6.2, R11.1, R12.2, R24.1, R25.1, R29.2, R35.1, R36.2, R37.2, R38.2, R39.2, R41.2, R43.2, R48.1, U5.4 (V-), U6.8 (gnd), U6.tab (gnd), U7.0 (Shell), U7.5 (Gnd), W6.2, W7.2, stm1.8 (Vssa), stm1.20 (PB2/BOOT1), stm1.23 (Vss_1), stm1.35 (Vss_2), stm1.47 (Vss_3)
unnamed: P4.2, Q1.D, W1.2
unnamed: Q8.3 (C), R30.2, R31.1
unnamed: Q10.G, R31.2
unnamed: Q4.G, R19.2
unnamed: Q12.3 (C), Q13.G, R48.2, R49.1
unnamed: Q6.3 (C), R19.1, R21.1
unnamed: Q3.G, R18.2
unnamed: Q5.3 (C), R18.1, R20.1
unnamed: Q12.2 (B), Q13.S, R46.2, R47.2
unnamed: Q7.1 (E), R29.1
unnamed: Q7.2 (B), R26.2
unnamed: Q2.2 (B), R10.2
unnamed: Q2.3 (C), R7.1, R9.1
unnamed: Q7.3 (C), Q9.G, Q11.G, R28.2
unnamed: Q1.G, R7.2
unnamed: C16.1, Q10.D, U6.9 (logic_Vss), W4.2
unnamed: R40.2, R41.1, U5.3 (+)
unnamed: R42.2, R43.1, U5.5 (+)
unnamed: R32.2, U7.2 (D-)
unnamed: R35.2, U7.4 (Id)
unnamed: C9.2, P9.1, R14.2, stm1.7 (NRST)
unnamed: P7.2 (PM), R12.1, stm1.44 (BOOT0)
unnamed: Q5.2 (B), R22.2
unnamed: Q8.2 (B), R27.2
unnamed: R13.2, stm1.6 (PD1/OSC_OUT)
unnamed: C7.2, X1.2, stm1.5 (PD0/OSC_IN)
unnamed: C8.2, R13.1, X1.1
unnamed: D2.1 (A), R3.2
unnamed: D1.1 (A), R1.2
unnamed: Q6.2 (B), R23.2
unnamed: P8.1, R17.1
unnamed: K2.3, Q12.1 (E), R46.1, R47.1, W10.1
unnamed: C4.1, C6.1, K1.1, R8.2, U3.2, U3.4, U4.2
unnamed: R6.1, R8.1, U3.1, U4.1
unnamed: R4.1, R5.1, U1.1, U2.1
unnamed: R33.2, R34.1, U7.3 (D+)
VDD: C3.1, C5.1, C10.1, C11.1, C12.1, C13.1, C14.1, P7.1, Q4.S, R2.2, R5.2, R14.1, R21.2, R40.1, R42.1, U1.2, U1.4, U2.2, U5.8 (V+), W3.1, stm1.1 (Vbat), stm1.9 (Vdda), stm1.24 (Vdd_1), stm1.36 (Vdd_2), stm1.48 (Vdd_3)

Notes on the sheet:
Chassis motors control cheme.
Indicator LEDs for debugging.
Addon power.
No I2C pullups here as there are on raspberry-pi.
Battery connection socket.
Cross board communication socket. There is one at this board. But there should be two neighbour such sockets on all other boards to be able to stack them together.
Two unconnected pins for screws. The newest Raspberry Pi contains holes for M2.5 screws.
Pin 1 is for sort of synchronization if required.
Serial bootloader activation socket.
Vo*R2/(R1+R2) = 1.25 R1=5k1, R2=3k3 => Vo=3.181818...V.
Vo*R2/(R1+R2) = 1.25 R1=10k, R2=3k => Vo=5V.
This one is optional for high voltages >20V.
RPi power.
If jumper is here USB is a voltage output.
If jumper is here USB is a voltage input.
Install either TO-220 or SO-223
Either on/off circuit or shourt-circuit wire.
Again either a couple of short circuit wires or on/off circuit.
Current limiting to 400mA when USB is used for powering the board.
This one isn't actually needed for current limiting. But when powered from battery with voltage >12V GS voltage shouldn't be greater then 12V. This resistor makes it 1/2 of batt+ value.
Current sense 0.1Ohm x 2units are 0.05Ohm. At 2Amps it would be P=2^2*0.05 = 0.2W. 0.1W per one R unit. And it is <0.125W.
Here again either short circuit wires or circuits for current limiting.
This comparator has open collector output type. So it matters only when level goes low.
Short to gnd should be done using electrolytic capacitor hole.

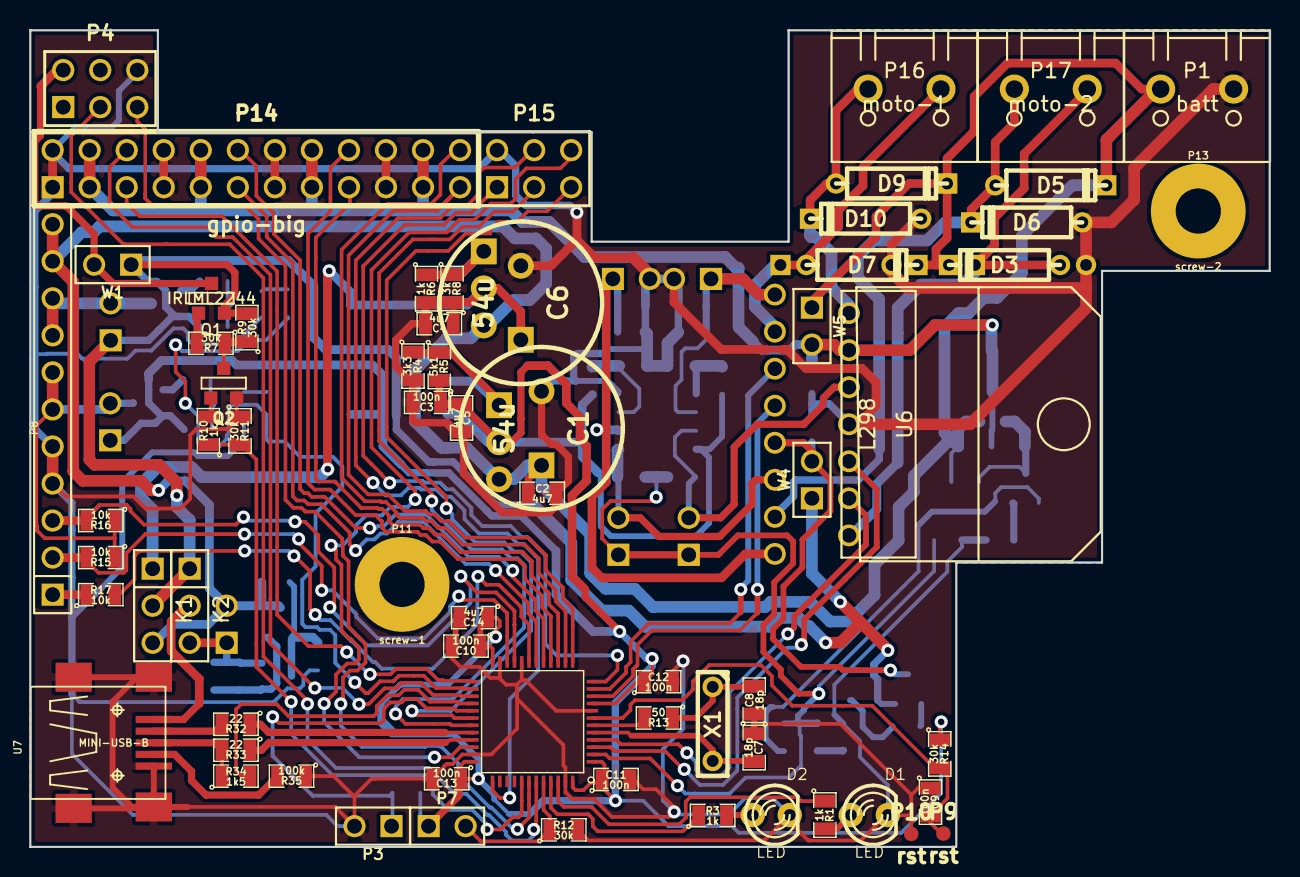
[picture p20: board main-board-2.kicad_pcb from above]

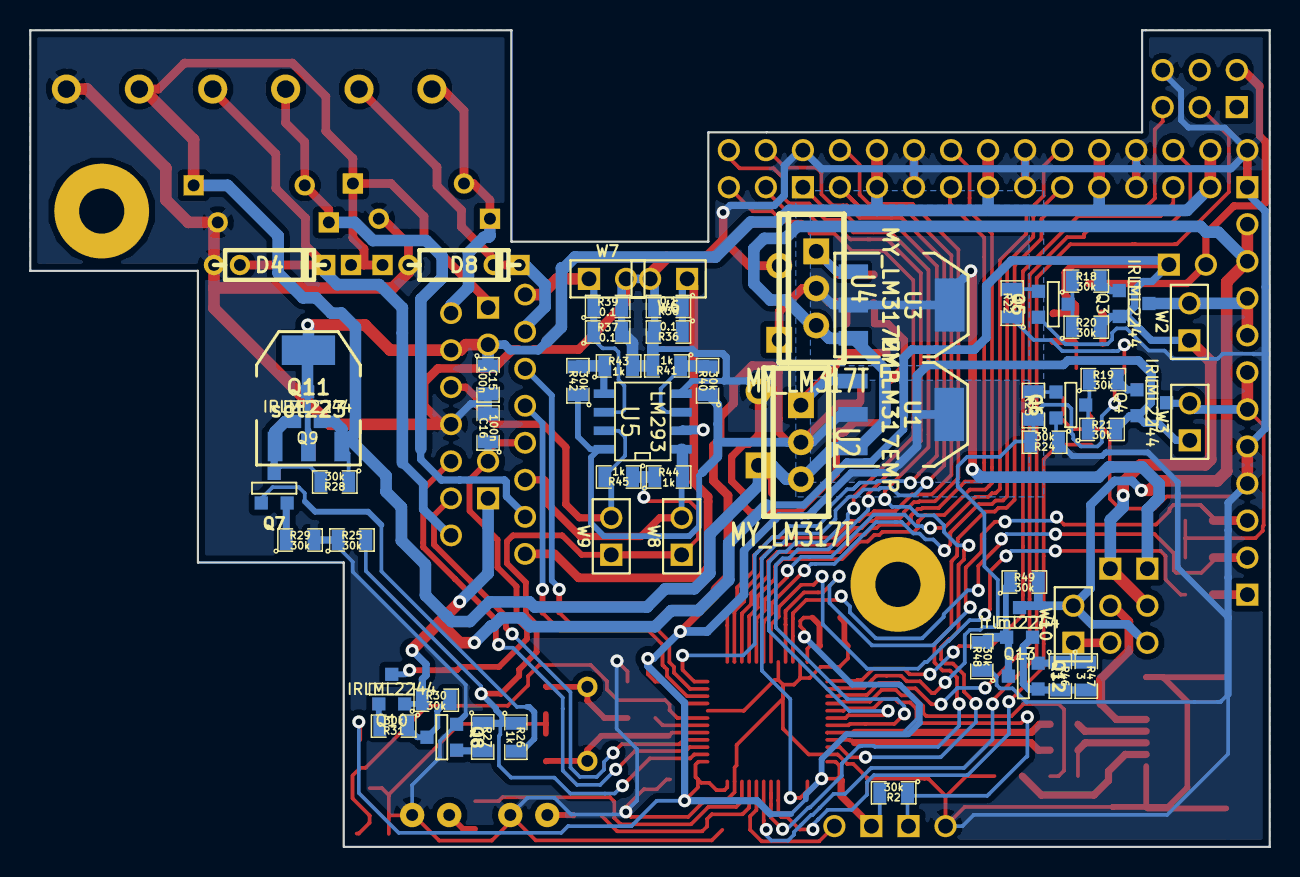
[picture p21: board main-board-2.kicad_pcb from below]

Board: 2 copper layers, 85.0 x 56.0 mm, 122 parts (56 on the bottom side), 83 nets.
