z80/supply/main-board/electric/scheme-cur-lim/curlim.kicad_pcb

## KiCad design main-board/electric/scheme-cur-lim/curlim.kicad_pcb (2013-10-29)

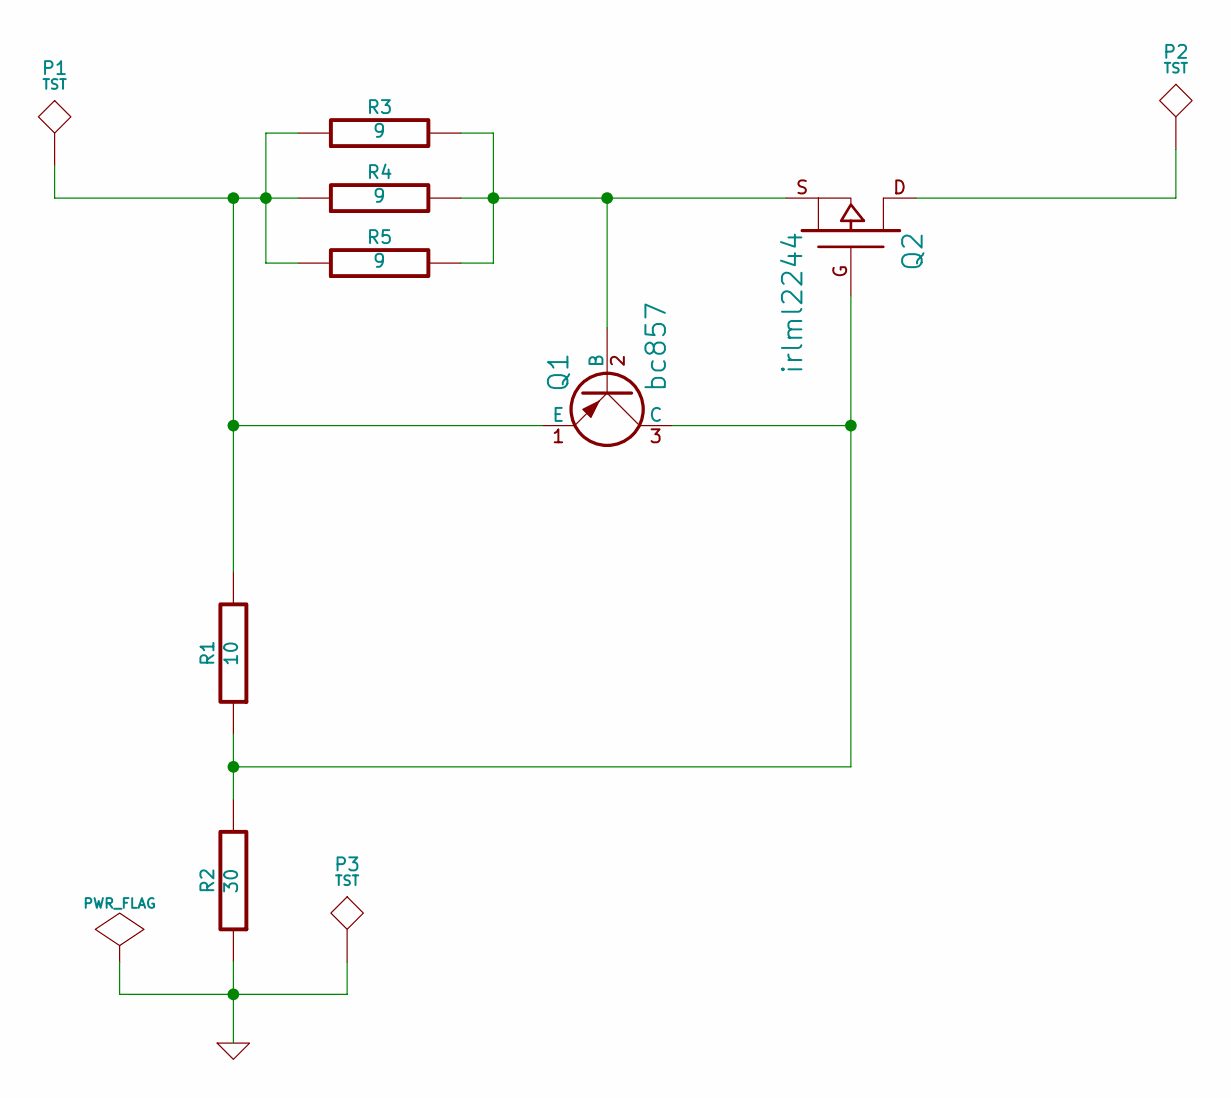
[picture p22: schematic curlim.sch]

Parts:
P1, P2, P3: TST
Q1: bc857
Q2: irlml2244
R1: 10
R2: 30
R3, R4, R5: 9

Connections:
GND: P3.1, R2.1
unnamed: Q1.3 (C), Q2.G, R1.1, R2.2
unnamed: P2.1, Q2.D
unnamed: Q1.2 (B), Q2.S, R3.2, R4.2, R5.2
unnamed: P1.1, Q1.1 (E), R1.2, R3.1, R4.1, R5.1

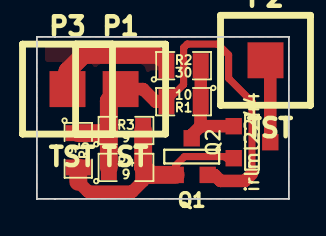
[picture p23: board curlim.kicad_pcb from above]

Board: 2 copper layers, 14.0 x 9.0 mm, 10 parts (0 on the bottom side), 5 nets.
