z80/supply/addon-board-generic/electric/scheme/addon-board.kicad_pcb

## KiCad design addon-board-generic/electric/scheme/addon-board.kicad_pcb (2013-09-11)

Schematic: addon-board.sch

Parts:
C1, C2, C3, C4, C5: 100n
C6: 10u
C7: 100n
C8: 10u
C9, C10: 18p
D1, D2: LED
K1, K2, K3, K4, K5, K6, K7, K8: CONN_3
P1, P2, P5, P6, P7, P8: TST
P3, P4: cross board conn
P9, P12, P13: CONN_4
P10: CONN_8
P11: CONN_10
Q1: NPN
Q2: IRLML2244
Q3, Q4: BC847
Q5, Q6: IRLML2244
R1, R2: 1k
R3, R4, R5, R6, R7, R8, R12, R13, R16, R17: 30k
R9: 1k
R10, R11: 30k
R14, R15: 500
R18, R19: 100
R20: 50
U1, U2: L293
U3: 74HC165
U4, U5: 74HC595_MY
X1: 8MHz
stm1: STM32F102C8T6

Connections:
+6V: Q5.S, Q6.S, R16.1, R17.1
/adc1: P10.1, stm1.11 (PA1/USART2_RTS/ADC_IN1/TIM2_CH2)
/adc2: P10.2, stm1.12 (PA2/USART2_TX/ADC_IN2/TIM2_CH3)
/adc3: P10.3, stm1.13 (PA3/USART2_RX/ADC_IN3/TIM2_CH4)
/adc4: P10.4, stm1.14 (PA4/SPI1_NSS/ADC_IN4/USART2_CK)
/adc5: P10.5, stm1.15 (PA5/SPI1_SCK/ADC_IN5)
/adc6: P10.6, stm1.16 (PA6/SPI1_MISO/ADC_IN6/TIM3_CH1)
/adc7: P10.7, stm1.17 (PA7/SPI1_MOSI/ADC_IN7/TIM3_CH2)
/addr0: P9.1, R8.2, stm1.27 (PB14/SPI2_MISO/USART3_RTS)
/addr1: P9.3, R7.2, stm1.28 (PB15/SPI2_MOSI)
/batt+: P3.8, P3.9, P4.8, P4.9, Q2.S
/buck-out-5v: P3.10, P3.11, P4.10, P4.11
/ds: U4.14, stm1.29 (PA8/USART1_CK/MCO)
/in0: P11.2, U3.11 (D0)
/in1: P11.3, U3.12 (D1)
/in2: P11.4, U3.13 (D2)
/in3: P11.5, U3.14 (D3)
/in4: P11.6, U3.3 (D4)
/in5: P11.7, U3.4 (D5)
/in6: P11.8, U3.5 (D6)
/in7: P11.9, U3.6 (D7)
/in-scl: U3.2 (CP), stm1.22 (PB11/I2C2_SDA/USART3_RX^TIM2_CH4)
/in-sda: U3.9 (Q7), stm1.21 (PB10/I2C2_SCL/USART3_TX^TIM2_CH3)
/iwakeup: P3.1, P4.1, R3.1
/led1: R1.1, U4.15
/led2: R2.1, U4.1
/moto1: U1.2 (in1), U4.4
/moto2: U1.9 (in2), U4.5
/moto3: U1.12 (in3), U4.6
/moto4: U1.19 (in4), U4.7
/moto5: U2.2 (in1), U5.15
/moto6: U2.9 (in2), U5.1
/moto7: U2.12 (in3), U5.2
/moto8: U2.19 (in4), U5.3
/moto-en1: R12.2, R14.1, U1.1 (en1), U1.11 (en2), U4.2
/moto-en2: R13.2, R15.1, U2.1 (en1), U2.11 (en2), U4.3
/mr: U4.10, U5.10, stm1.33 (PA12/USART1_RTS/USBDP)
/oe: U4.13, U5.13, stm1.30 (PA9/USART1_TX)
/out1: P12.3, U1.3 (out1)
/out2: P12.4, U1.8 (out2)
/out3: P12.1, U1.13 (out3)
/out4: P12.2, U1.18 (out4)
/out5: P13.3, U2.3 (out1)
/out6: P13.4, U2.8 (out2)
/out7: P13.1, U2.13 (out3)
/out8: P13.2, U2.18 (out4)
/scl-int: P3.3, P4.3, stm1.42 (PB6/I2C1_SCL/TIM4_CH1^USART1_TX)
/sda-int: P3.2, P4.2, stm1.43 (PB7/I2C1_SDA/TIM4_CH3^USART1_RX)
/servo1: K1.1, stm1.39 (JTDO^TIM2_CH2/PB3/TRACESWO/SPI1_SCKPB3)
/servo2: K2.1, stm1.40 (JNTRST^TIM3_CH1/PB4/SPI1_MISO)
/servo3: K3.1, stm1.41 (PB5/I2C1_SMBA^TIM3_CH2/SPI1_MOSI)
/servo4: K4.1, stm1.45 (PB8/TIM4_CH3^I2C1_SCL)
/servo5: K5.1, stm1.46 (PB9/TIM4_CH4^I2C1_SDA)
/servo6: K6.1, stm1.19 (PB1/ADC_IN9/TIM3_CH4)
/servo7: K7.1, stm1.18 (PB0/ADC_IN8/TIM3_CH3)
/servo8: K8.1, stm1.10 (PA0/WKUP/USART2_CTS/ADC_IN0/TIM2_CH1_ETR)
/servo-en: R9.1, U5.4
/servo-vdd+: C7.2, C8.2, K1.2 (PM), K2.2 (PM), K3.2 (PM), K4.2 (PM), K5.2 (PM), K6.2 (PM), K7.2 (PM), K8.2 (PM), Q2.D
/shcp: U4.11, U5.11, stm1.32 (PA11/USART1_CTS/USBDM)
/stcp: U4.12, U5.12, stm1.31 (PA10/USART1_RX)
/swd-clk: P5.1, stm1.37 (JTCK/SWCLK^PA14)
/swd-io: P6.1, stm1.34 (JTMS/SWDIO^PA13)
/wakeup: R3.2, stm1.3 (PC14/OSC32_IN)
/~in-load: U3.1 (~PL), stm1.26 (PB13/SPI2_SCK/USART3_CTS)
/~in-scl-en: U3.15 (~CE), stm1.25 (PB12/SPI2_NSS/I2C2_SMBA/USART3_CTS)
GND: C1.1, C2.2, C3.2, C4.2, C5.2, C6.2, C8.1, C9.1, C10.1, D1.2 (K), D2.2 (K), K1.3, K2.3, K3.3, K4.3, K5.3, K6.3, K7.3, K8.3, P3.4, P3.5, P4.4, P4.5, P7.1, P9.2, P9.4, P10.8, P11.1, P11.10, Q1.1 (E), Q3.1 (E), Q4.1 (E), R4.2, R5.2, R10.1, R11.2, R12.1, R13.1, U1.4 (gnd), U1.5 (gnd), U1.6 (gnd), U1.7 (gnd), U1.14 (gnd), U1.15 (gnd), U1.16 (gnd), U1.17 (gnd), U2.4 (gnd), U2.5 (gnd), U2.6 (gnd), U2.7 (gnd), U2.14 (gnd), U2.15 (gnd), U2.16 (gnd), U2.17 (gnd), U3.8 (GND), U4.8, U5.8, stm1.8 (Vssa), stm1.23 (Vss_1), stm1.35 (Vss_2), stm1.47 (Vss_3)
unnamed: Q3.3 (C), R16.2, R18.1
unnamed: Q5.D, U1.10 (vs), U1.20 (vss)
unnamed: Q5.G, R18.2
unnamed: Q3.2 (B), R14.2
unnamed: Q6.D, U2.10 (vs), U2.20 (vss)
unnamed: R4.1, stm1.44 (BOOT0)
unnamed: U4.9, U5.14
unnamed: C1.2, R6.2, stm1.7 (NRST)
unnamed: R5.1, stm1.20 (PB2/BOOT1)
unnamed: D2.1 (A), R2.2
unnamed: D1.1 (A), R1.2
unnamed: R20.2, stm1.6 (PD1/OSC_OUT)
unnamed: C10.2, R20.1, X1.1
unnamed: C9.2, X1.2, stm1.5 (PD0/OSC_IN)
unnamed: C7.1, Q1.3 (C), Q2.G, R11.1
unnamed: Q1.2 (B), R9.2, R10.2
unnamed: Q6.G, R19.2
unnamed: Q4.3 (C), R17.2, R19.1
unnamed: Q4.2 (B), R15.2
VDD: C2.1, C3.1, C4.1, C5.1, C6.1, P3.6, P3.7, P4.6, P4.7, R6.1, R7.1, R8.1, U3.10 (DS), U3.16 (VCC), U4.16, U5.16, stm1.1 (Vbat), stm1.9 (Vdda), stm1.24 (Vdd_1), stm1.36 (Vdd_2), stm1.48 (Vdd_3)

Notes on the sheet:
Chassis motors control cheme.
Indicator LEDs for debugging.
Programming socket is planned to be made of individual pads. And programming cable is supposed to be attached with crocodile clip.
Cross board communication socket. There is one at this board. But there should be two neighbour such sockets on all other boards to be able to stack them together.
Two unconnected pins for screws. The newest Raspberry Pi contains holes for M3 screws.
And four for screws at board corners.
Pin 1 is for waking up all other boards.

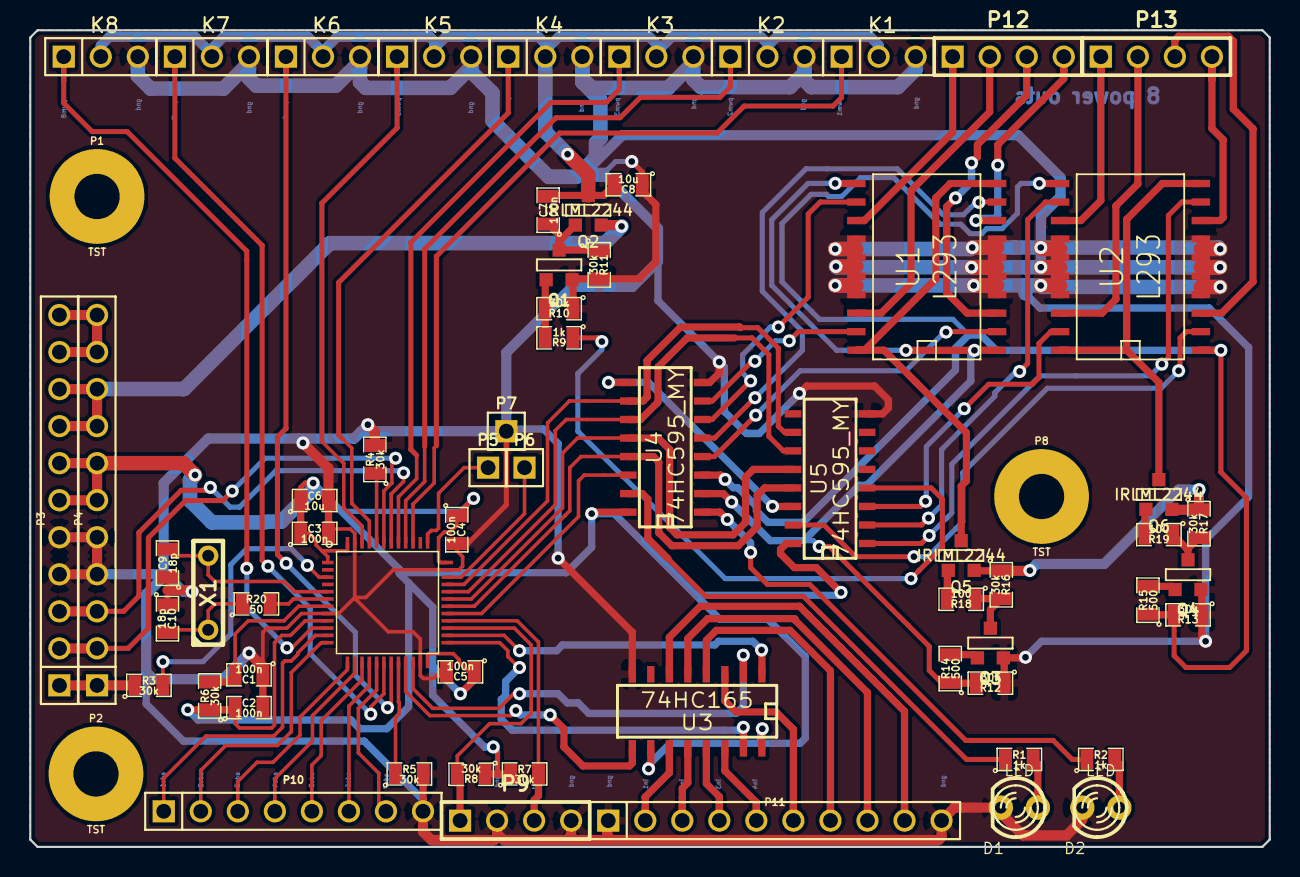
[picture p24: board addon-board.kicad_pcb from above]

Board: 2 copper layers, 85.0 x 56.0 mm, 66 parts (0 on the bottom side), 86 nets.
