z80/supply/main-board/electric/scheme/supply-board.kicad_pcb

## KiCad design main-board/electric/scheme/supply-board.kicad_pcb (2013-09-11)

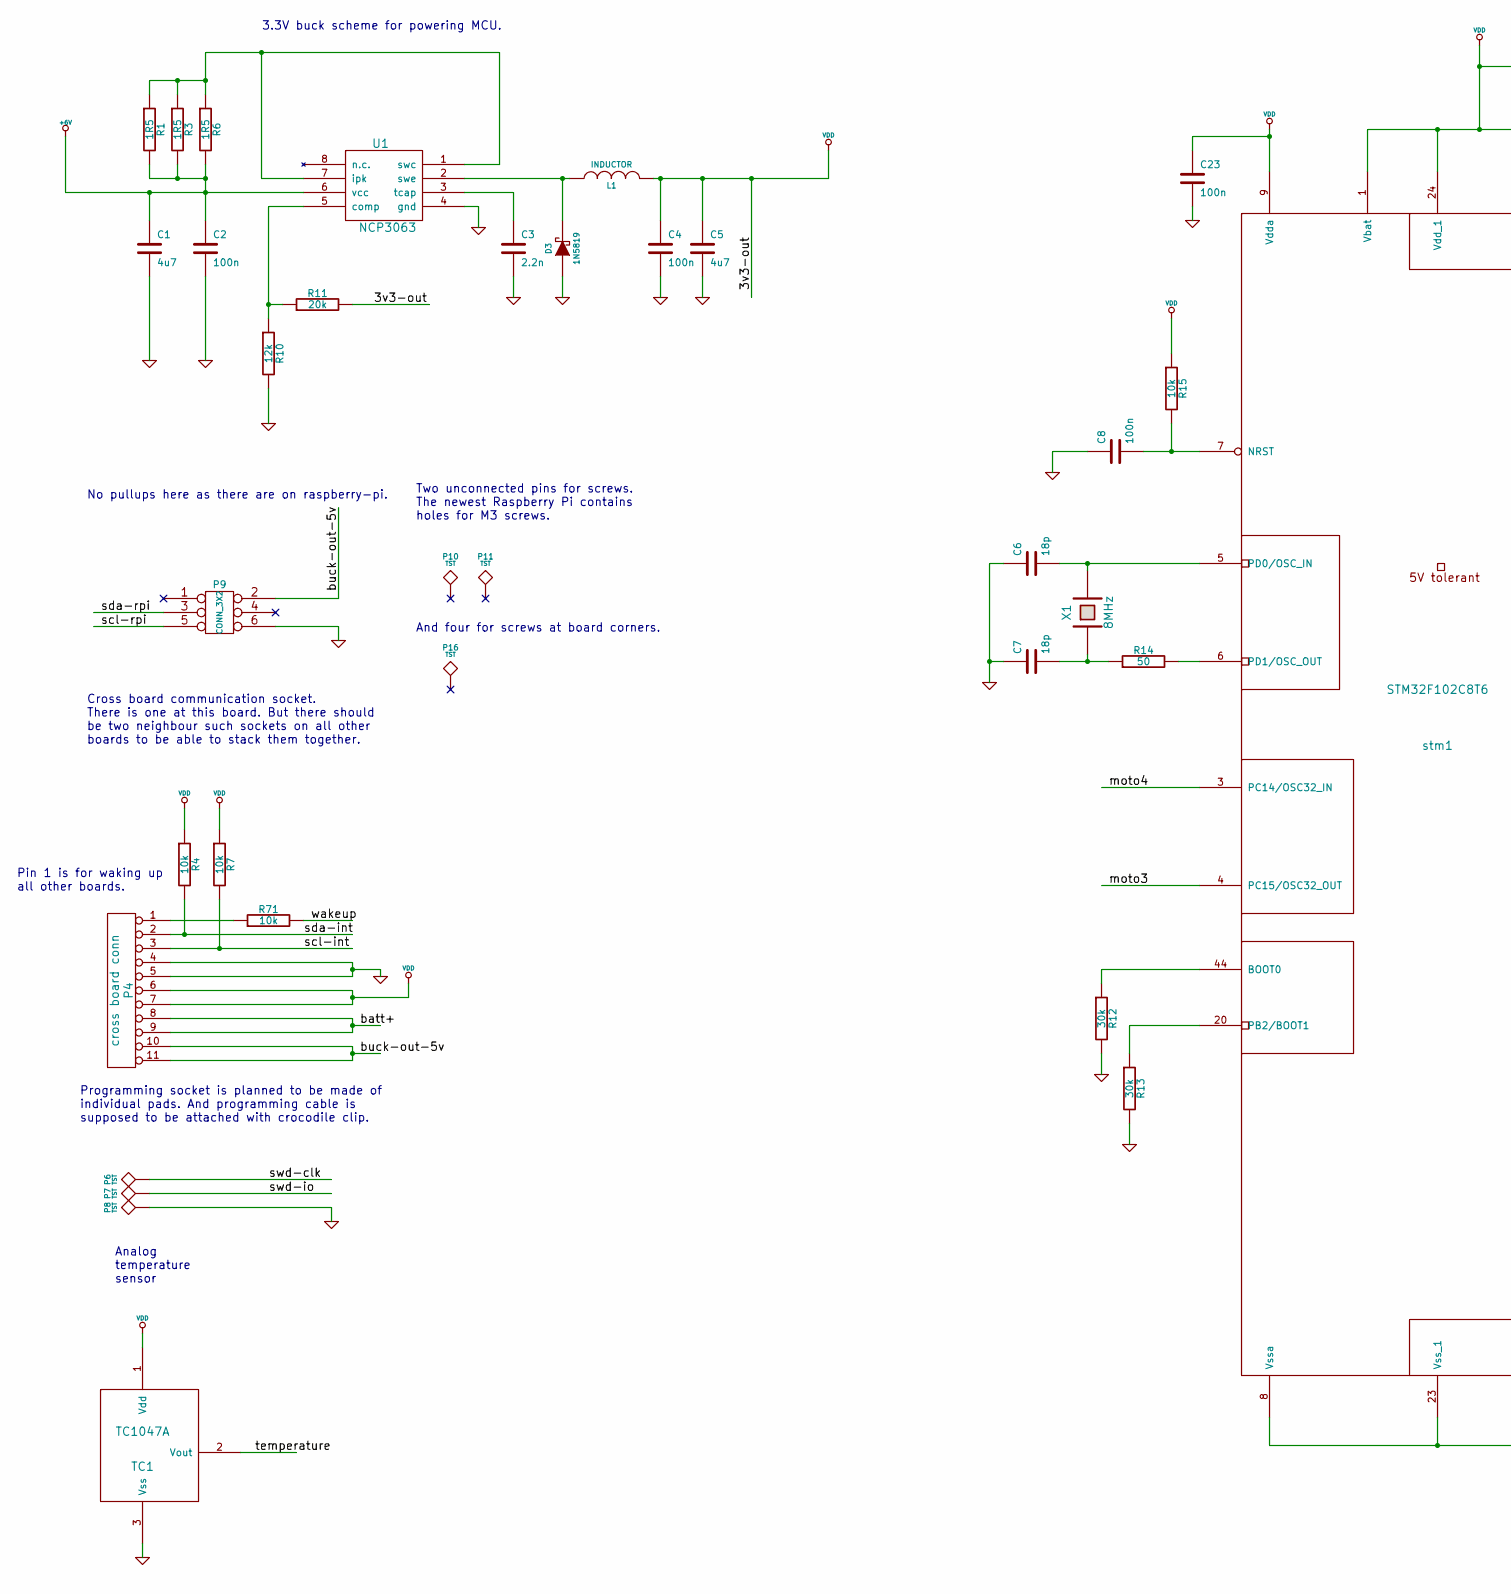
[picture p25: schematic supply-board.sch, part in row 1, column 1]

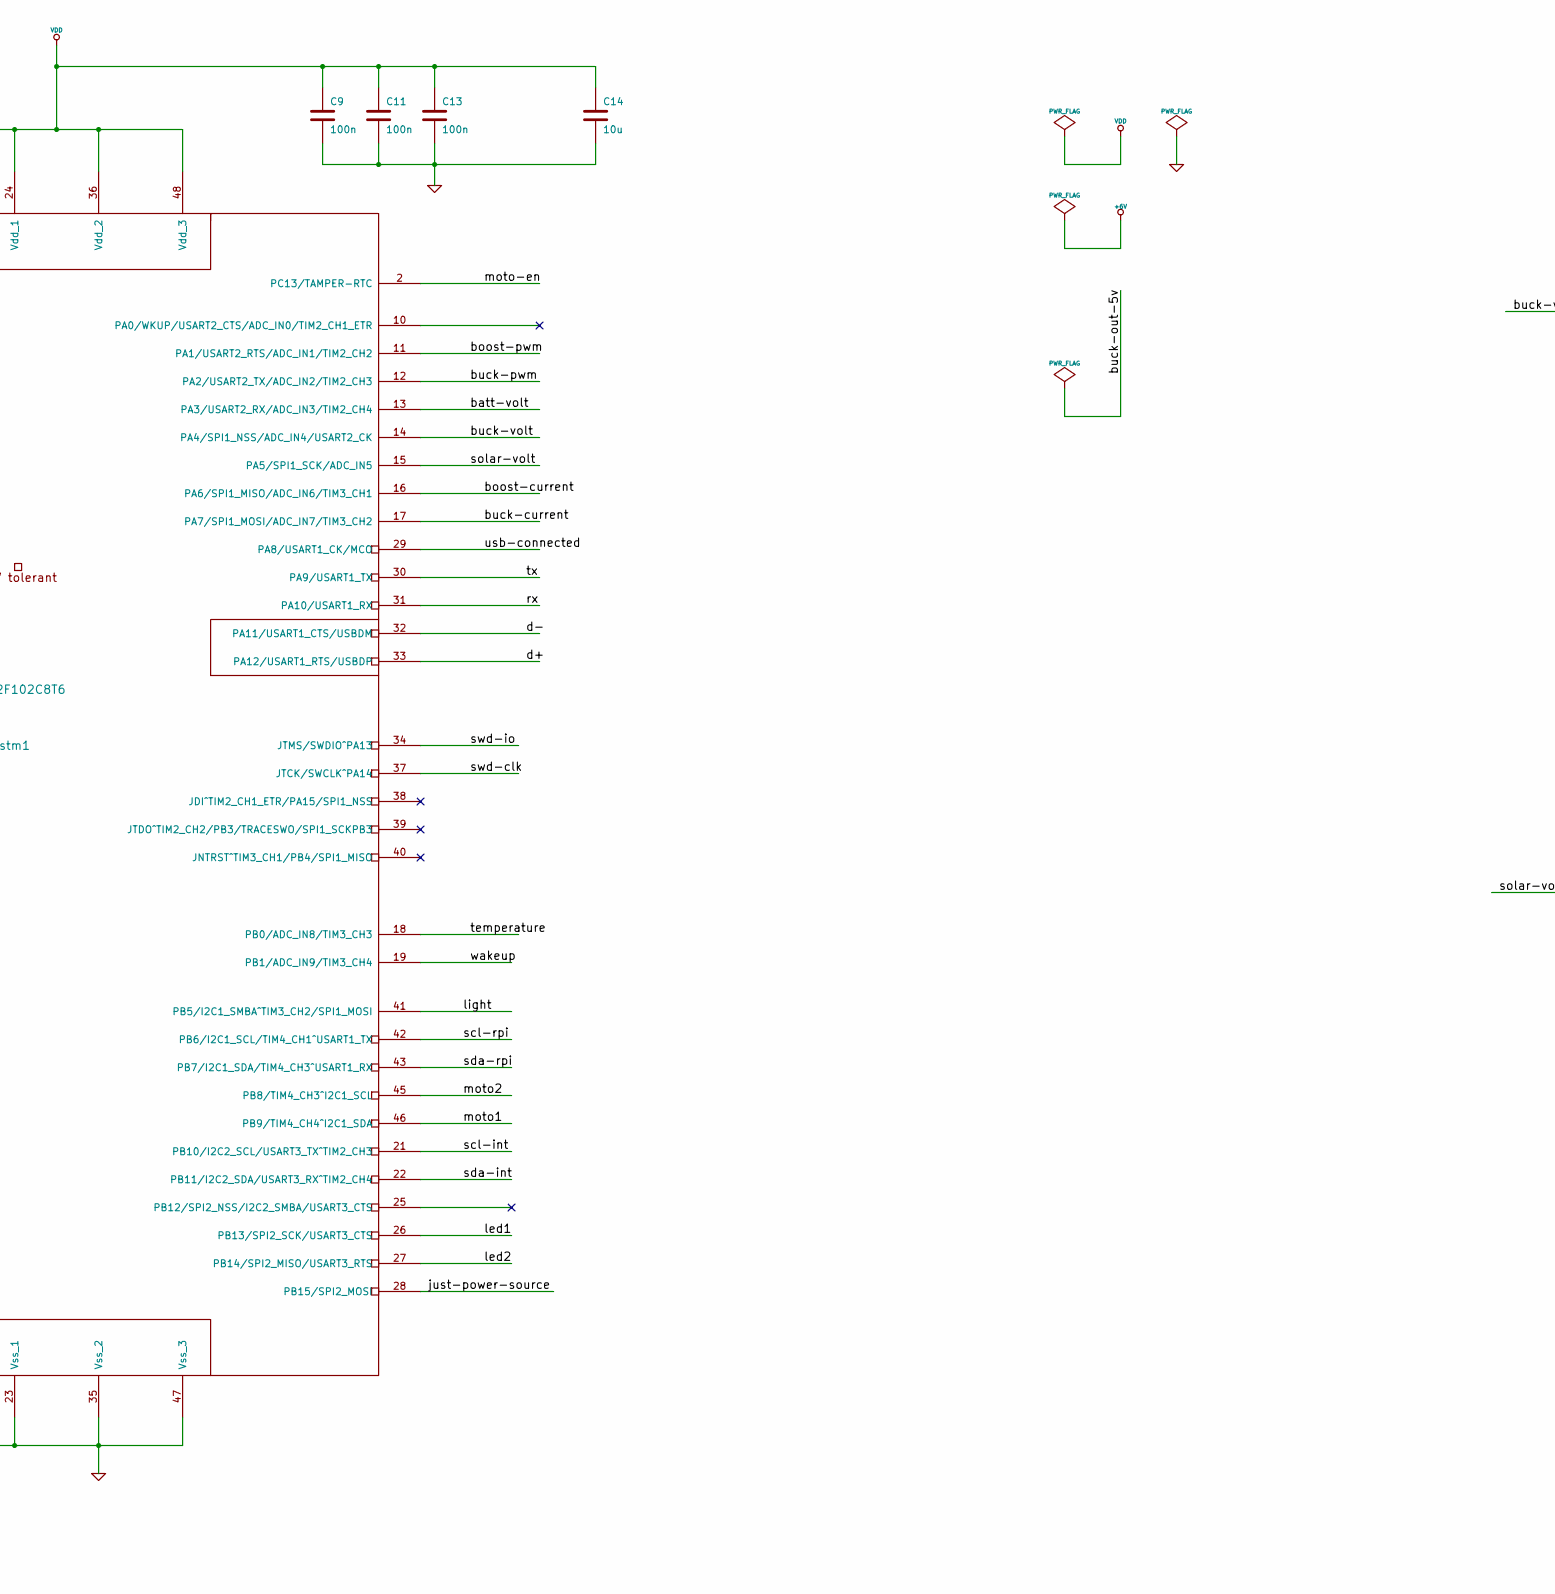
[picture p26: schematic supply-board.sch, part in row 1, column 2]

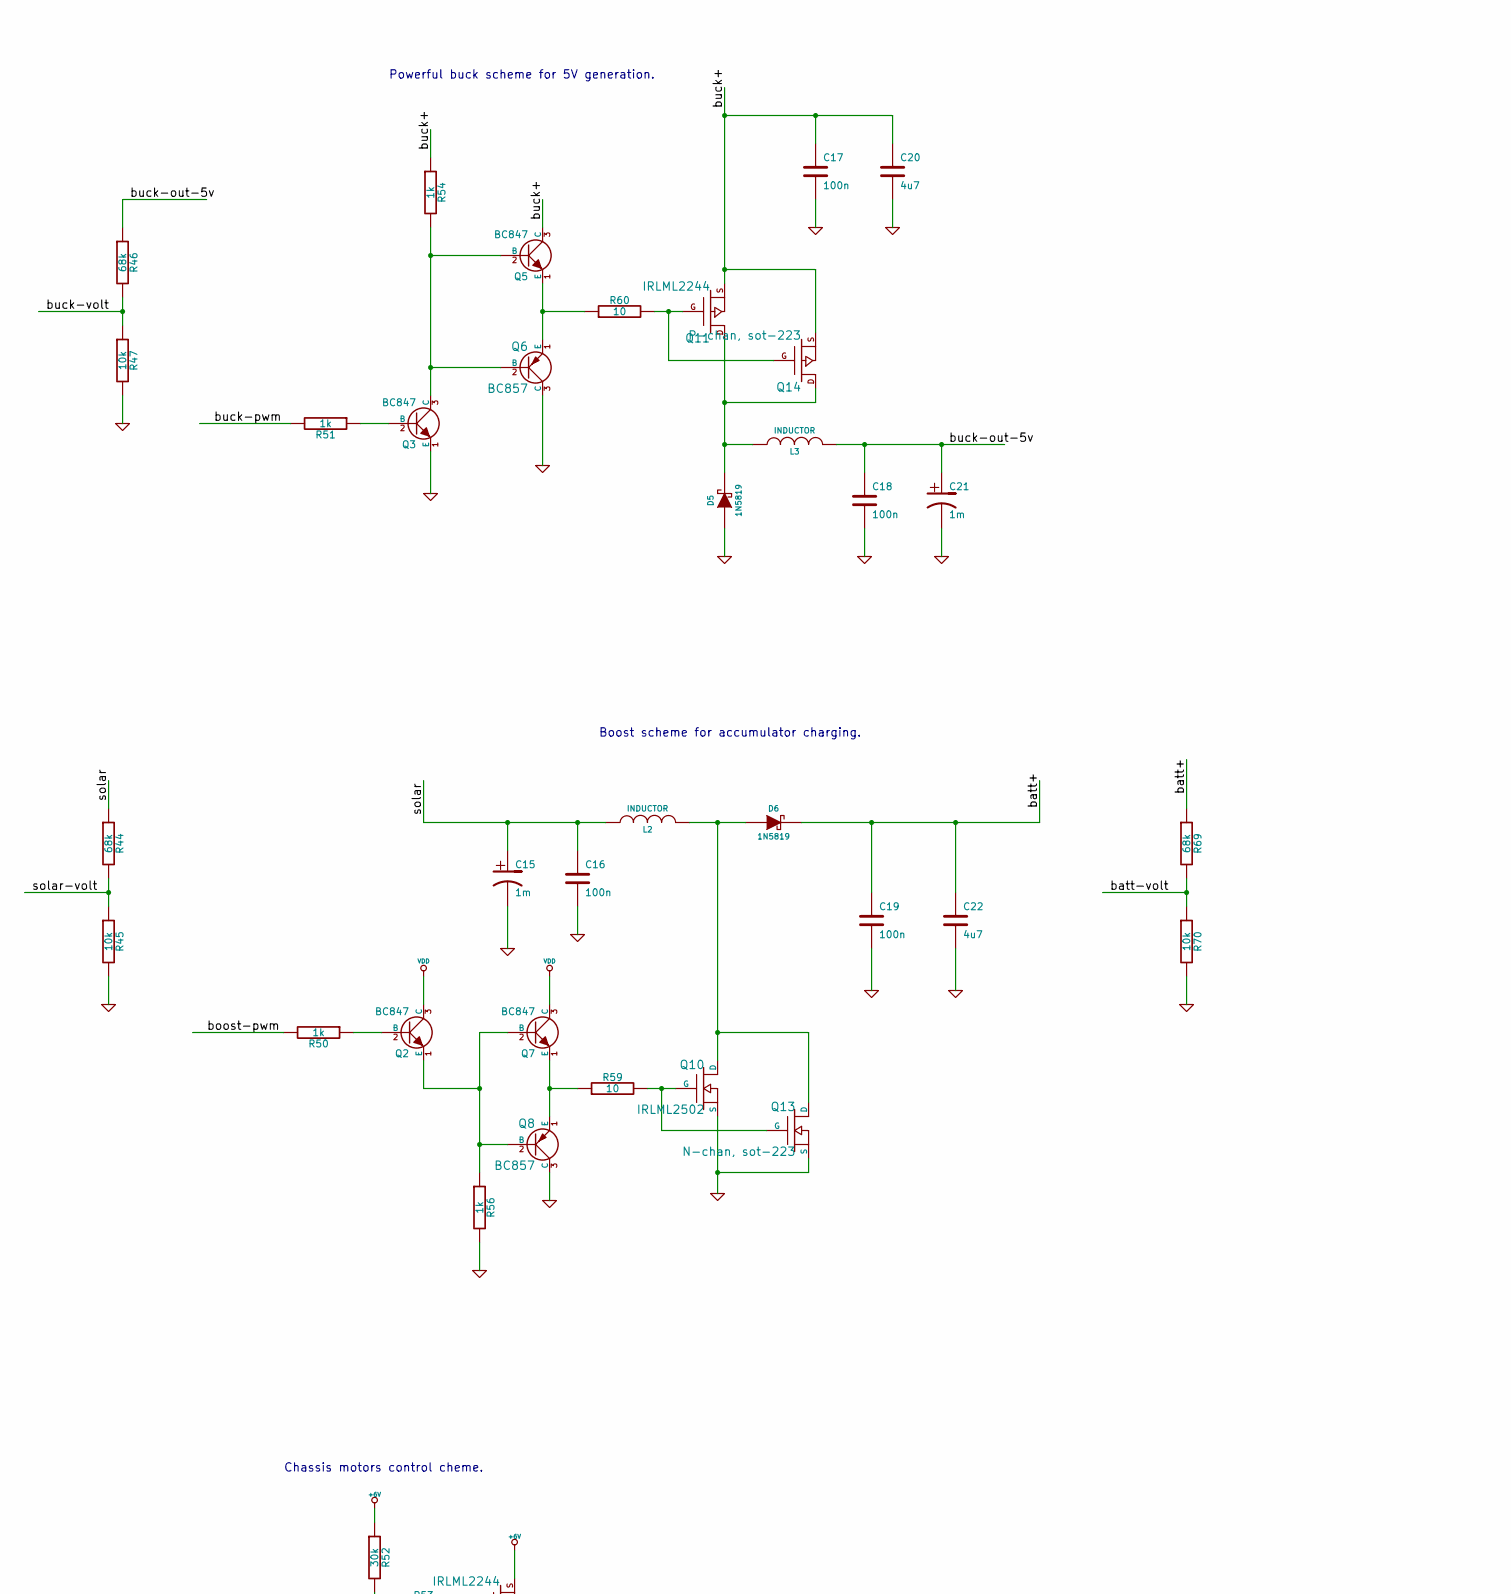
[picture p27: schematic supply-board.sch, part in row 1, column 3]

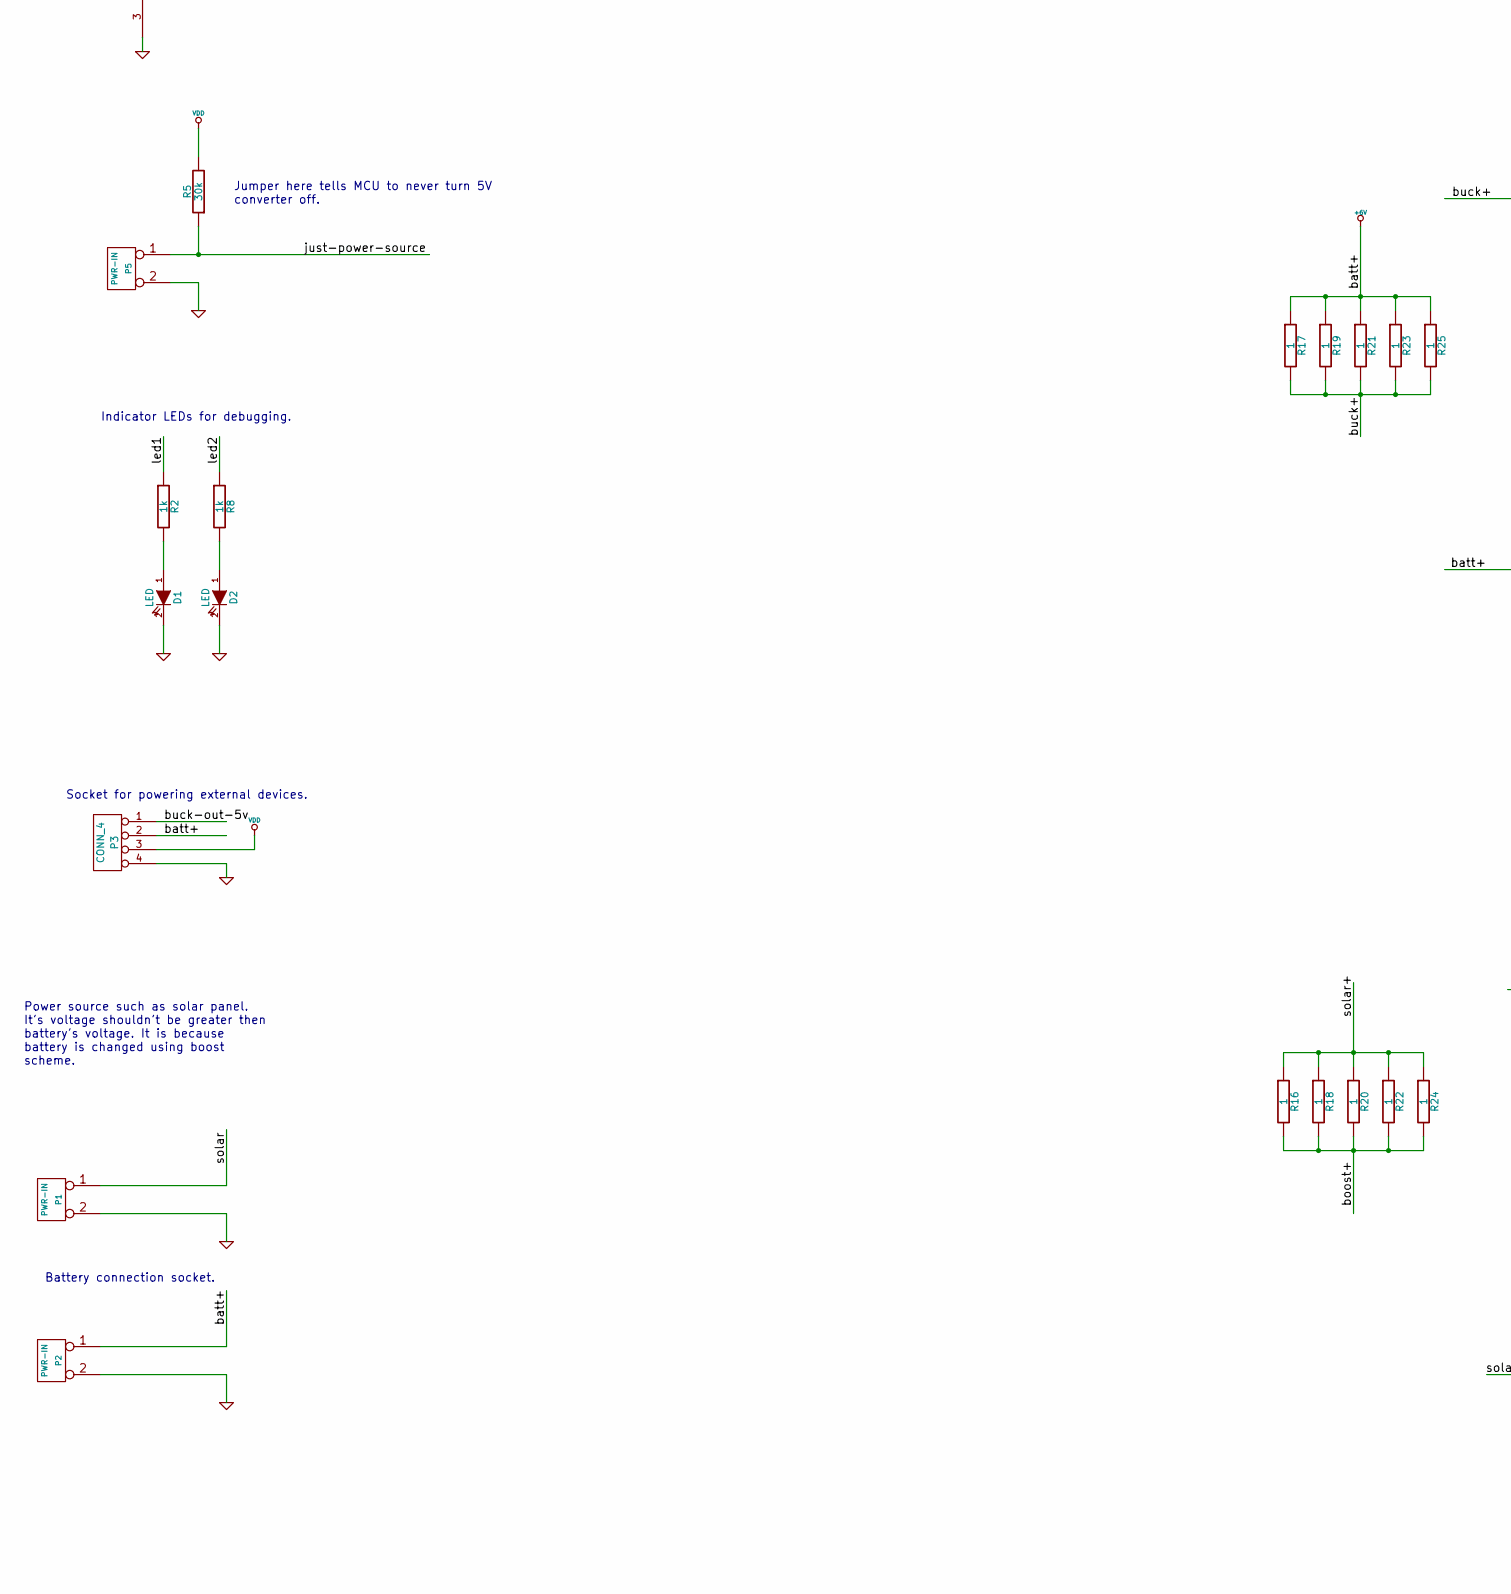
[picture p28: schematic supply-board.sch, part in row 2, column 1]

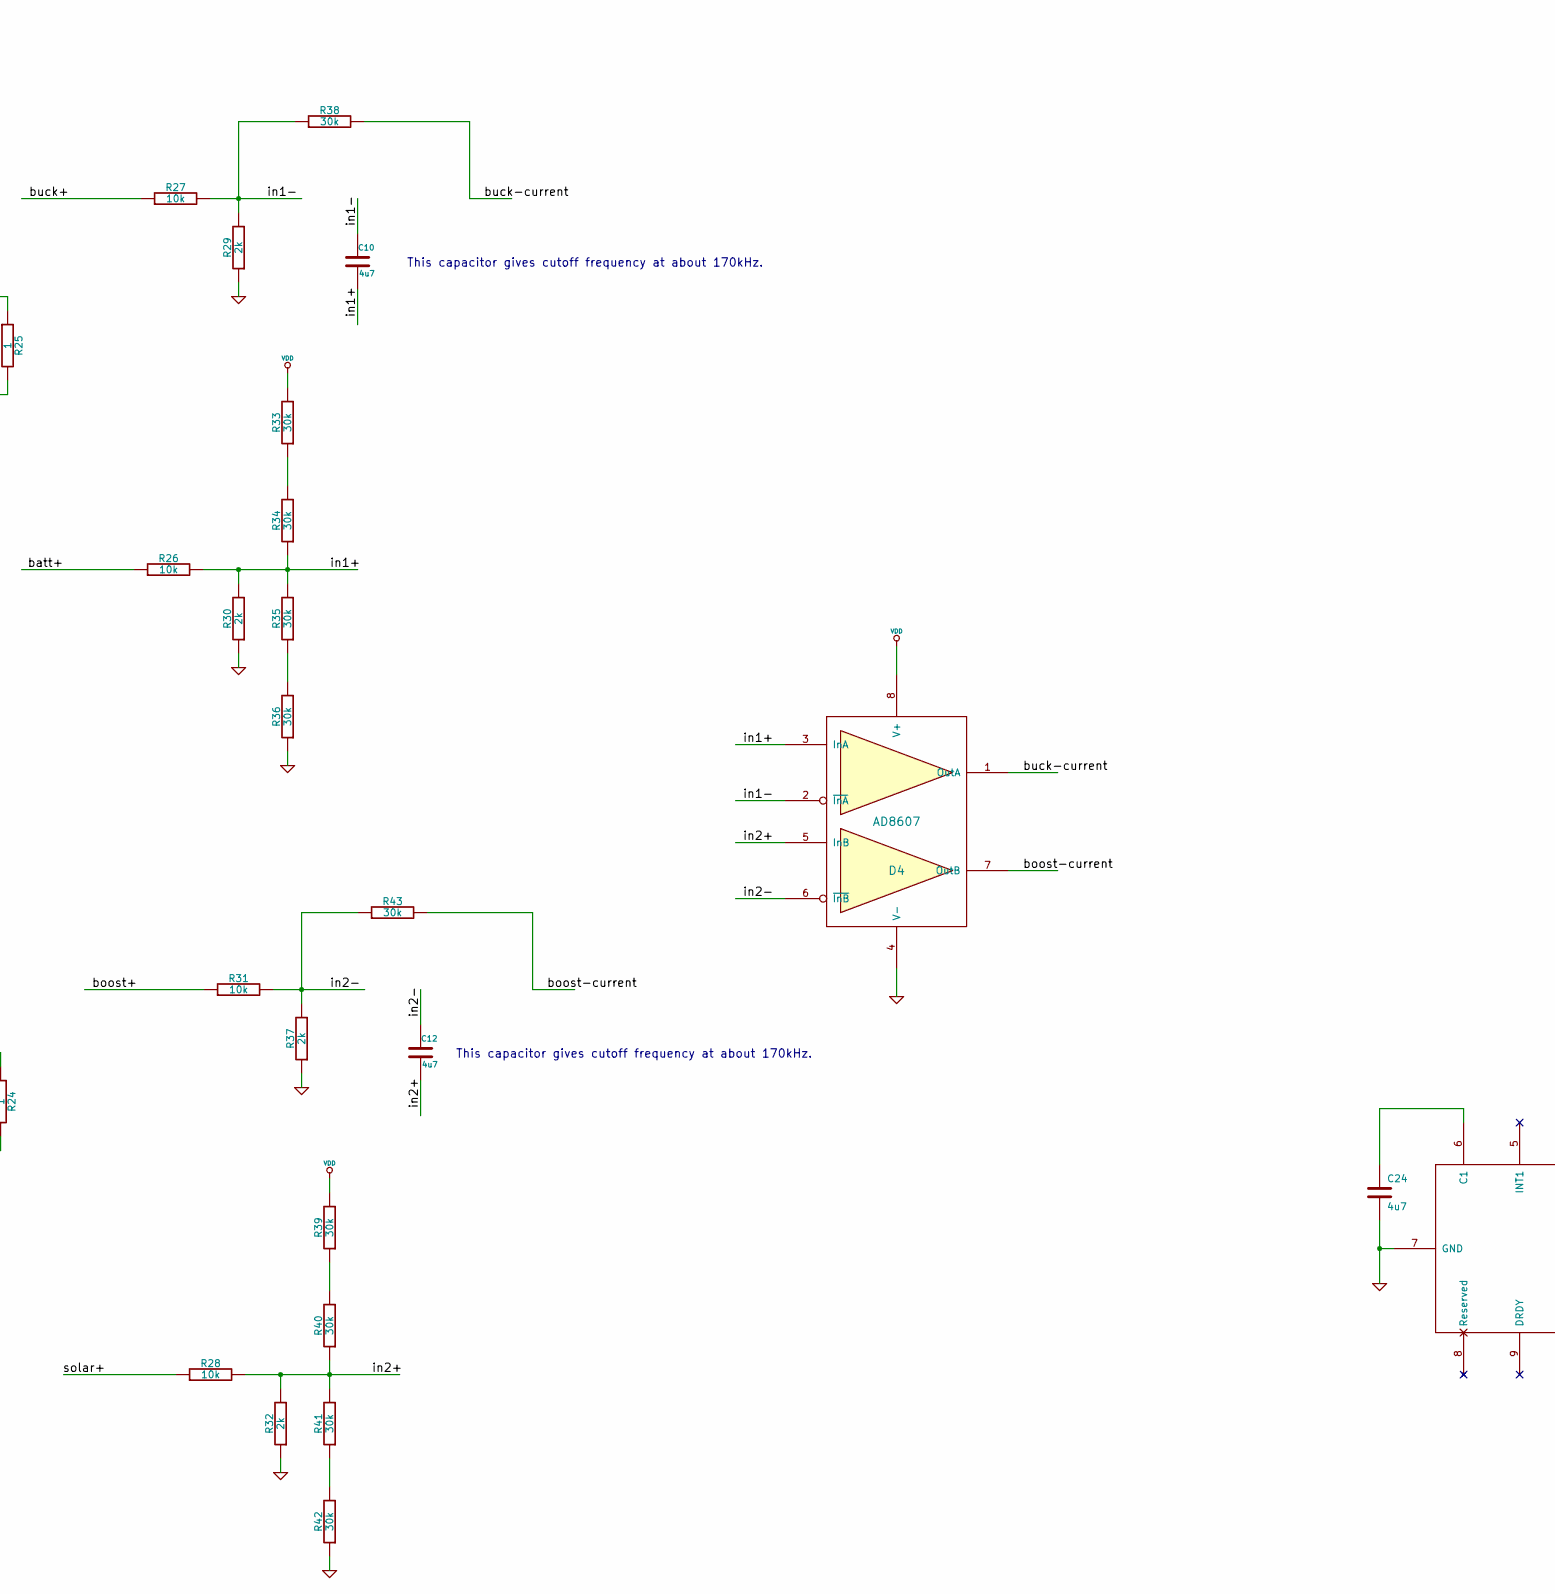
[picture p29: schematic supply-board.sch, part in row 2, column 2]

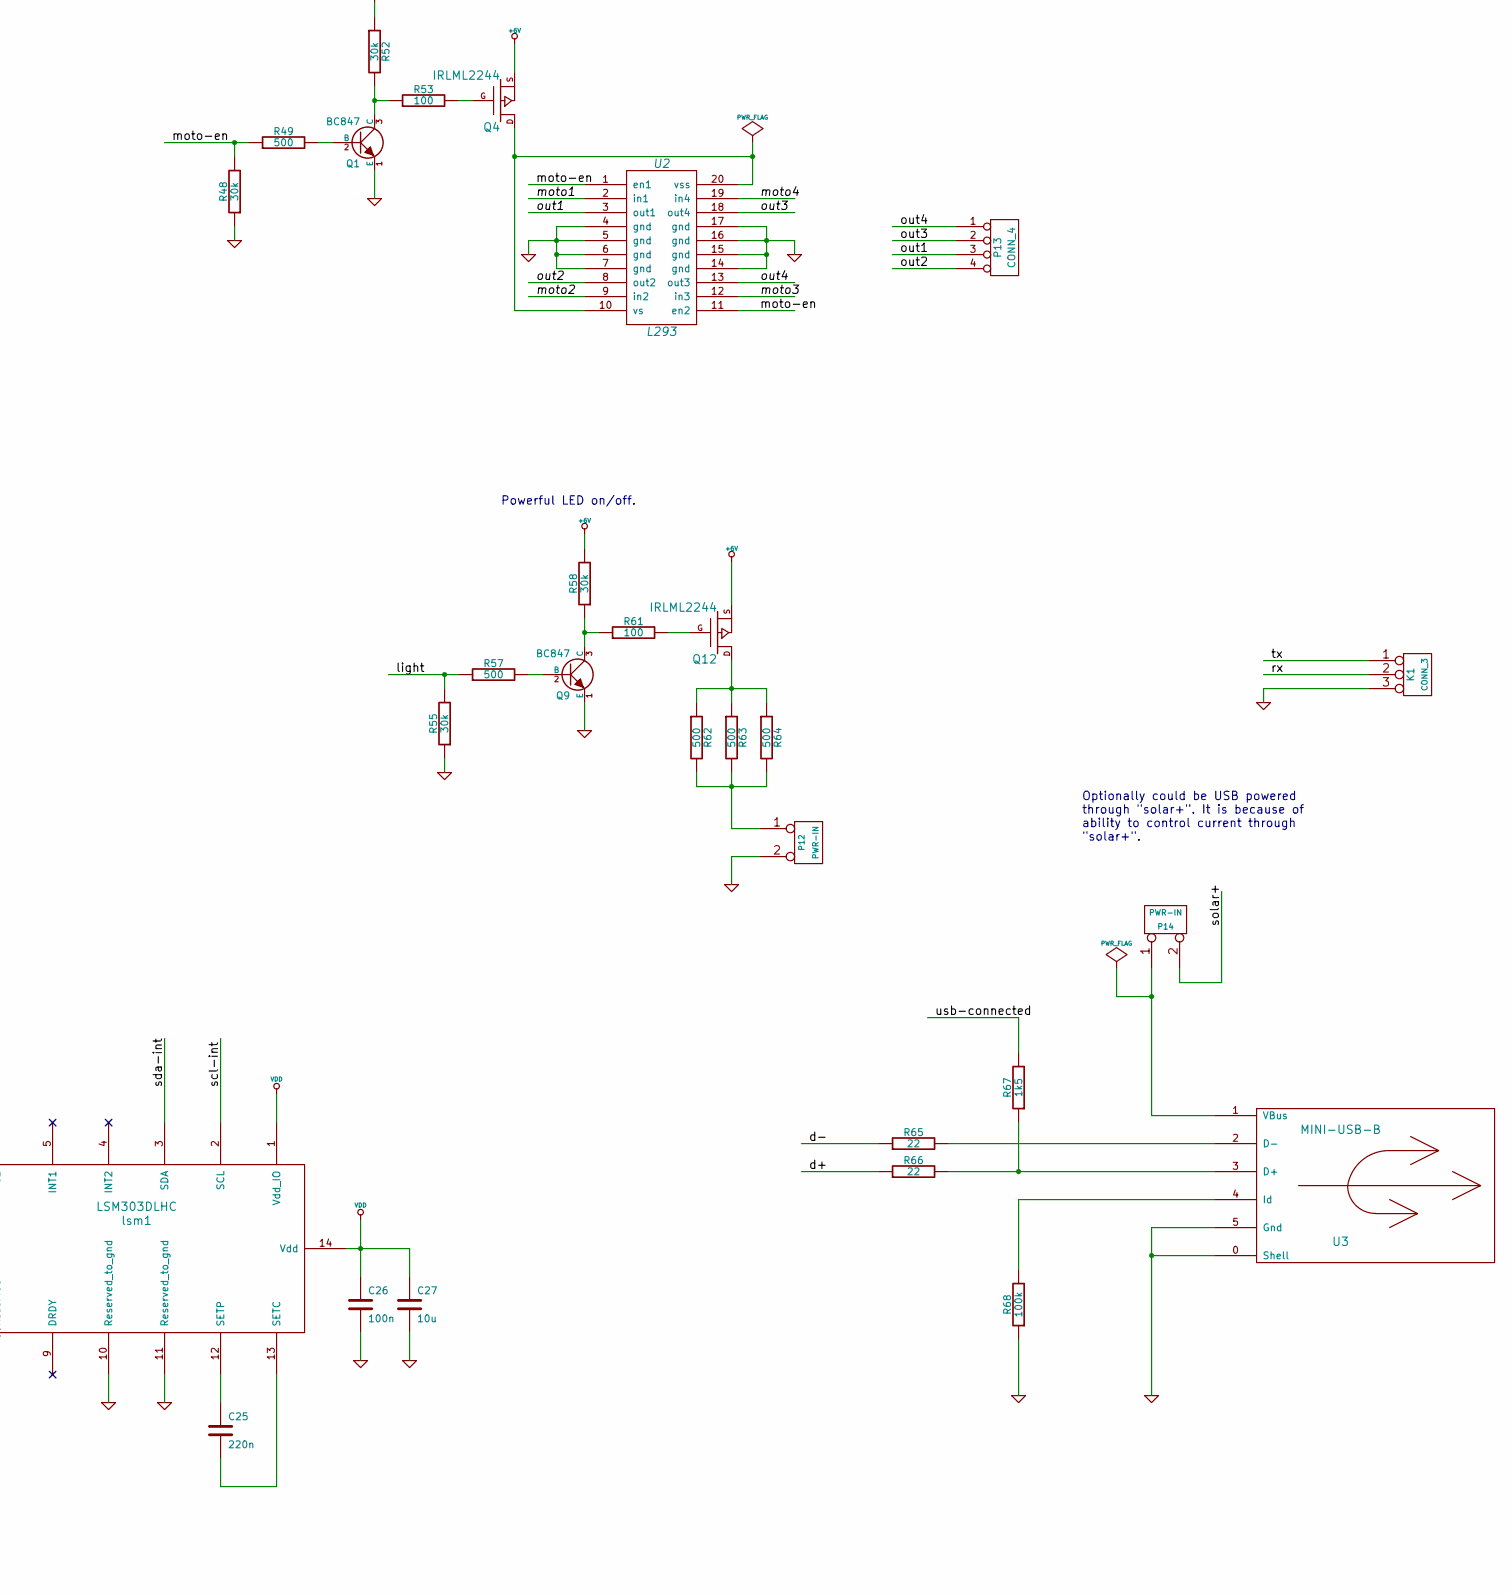
[picture p30: schematic supply-board.sch, part in row 2, column 3]

Parts:
C1, C5, C20, C22, C24: 4u7
C2, C4, C8, C9, C11, C13, C16, C17, C18, C19, C23, C26: 100n
C3: 2.2n
C6, C7: 18p
C10, C12: 4u7
C14, C27: 10u
C15, C21: 1m
C25: 220n
D1, D2: LED
D3, D5, D6: 1N5819
D4: AD8607
K1: CONN_3
L1, L2, L3: INDUCTOR
P1, P2, P5, P12, P14: PWR-IN
P3, P13: CONN_4
P4: cross board conn
P6, P7, P8, P10, P11, P16: TST
P9: CONN_3X2
Q1, Q2, Q3, Q5, Q7, Q9: BC847
Q4, Q11, Q12: IRLML2244
Q6, Q8: BC857
Q10: IRLML2502
Q13: N-chan, sot-223
Q14: P-chan, sot-223
R1, R3, R6: 1R5
R2, R8, R50, R51, R54, R56: 1k
R4, R7, R15, R26, R27, R28, R31, R45, R47, R70, R71: 10k
R5, R12, R13, R33, R34, R35, R36, R38, R39, R40, R41, R42, R43, R48, R52, R55, R58: 30k
R10: 12k
R11: 20k
R14: 50
R16, R17, R18, R19, R20, R21, R22, R23, R24, R25: 1
R29, R30, R32, R37: 2k
R44, R46, R69: 68k
R49, R57, R62, R63, R64: 500
R53, R61: 100
R59, R60: 10
R65, R66: 22
R67: 1k5
R68: 100k
TC1: TC1047A
U1: NCP3063
U2: L293
U3: MINI-USB-B
X1: 8MHz
lsm1: LSM303DLHC
stm1: STM32F102C8T6

Connections:
+6V: C1.1, C2.1, C19.1, C22.1, D6.2 (K), P2.1, P3.2, P4.8, P4.9, Q4.S, Q12.S, R1.2, R3.2, R6.2, R17.1, R19.1, R21.1, R23.1, R25.1, R26.1, R52.1, R58.2, R69.1, U1.6 (vcc)
/batt-volt: R69.2, R70.1, stm1.13 (PA3/USART2_RX/ADC_IN3/TIM2_CH4)
/boost+: R16.2, R18.2, R20.2, R22.2, R24.2, R31.1
/boost-current: D4.7 (OutB), R43.2, stm1.16 (PA6/SPI1_MISO/ADC_IN6/TIM3_CH1)
/boost-pwm: R50.2, stm1.11 (PA1/USART2_RTS/ADC_IN1/TIM2_CH2)
/buck+: C17.1, C20.1, Q5.3 (C), Q11.S, Q14.S, R17.2, R19.2, R21.2, R23.2, R25.2, R27.1, R54.1
/buck-current: D4.1 (OutA), R38.2, stm1.17 (PA7/SPI1_MOSI/ADC_IN7/TIM3_CH2)
/buck-out-5v: C18.1, C21.1, L3.2, P3.1, P4.10, P4.11, P9.2, R46.1
/buck-pwm: R51.2, stm1.12 (PA2/USART2_TX/ADC_IN2/TIM2_CH3)
/buck-volt: R46.2, R47.1, stm1.14 (PA4/SPI1_NSS/ADC_IN4/USART2_CK)
/d+: R66.1, stm1.33 (PA12/USART1_RTS/USBDP)
/d-: R65.1, stm1.32 (PA11/USART1_CTS/USBDM)
/in1+: C10.2, D4.3 (InA), R26.2, R30.2, R34.1, R35.2
/in1-: C10.1, D4.2 (~InA~), R27.2, R29.2, R38.1
/in2+: C12.2, D4.5 (InB), R28.2, R32.2, R40.1, R41.2
/in2-: C12.1, D4.6 (~InB~), R31.2, R37.2, R43.1
/just-power-source: P5.1, R5.1, stm1.28 (PB15/SPI2_MOSI)
/led1: R2.1, stm1.26 (PB13/SPI2_SCK/USART3_CTS)
/led2: R8.1, stm1.27 (PB14/SPI2_MISO/USART3_RTS)
/light: R55.2, R57.1, stm1.41 (PB5/I2C1_SMBA^TIM3_CH2/SPI1_MOSI)
/moto1: U2.2 (in1), stm1.46 (PB9/TIM4_CH4^I2C1_SDA)
/moto2: U2.9 (in2), stm1.45 (PB8/TIM4_CH3^I2C1_SCL)
/moto3: U2.12 (in3), stm1.4 (PC15/OSC32_OUT)
/moto4: U2.19 (in4), stm1.3 (PC14/OSC32_IN)
/moto-en: R48.2, R49.1, U2.1 (en1), U2.11 (en2), stm1.2 (PC13/TAMPER-RTC)
/out1: P13.3, U2.3 (out1)
/out2: P13.4, U2.8 (out2)
/out3: P13.2, U2.18 (out4)
/out4: P13.1, U2.13 (out3)
/rx: K1.2 (PM), stm1.31 (PA10/USART1_RX)
/scl-int: P4.3, R7.2, lsm1.2 (SCL), stm1.21 (PB10/I2C2_SCL/USART3_TX^TIM2_CH3)
/scl-rpi: P9.5, stm1.42 (PB6/I2C1_SCL/TIM4_CH1^USART1_TX)
/sda-int: P4.2, R4.2, lsm1.3 (SDA), stm1.22 (PB11/I2C2_SDA/USART3_RX^TIM2_CH4)
/sda-rpi: P9.3, stm1.43 (PB7/I2C1_SDA/TIM4_CH3^USART1_RX)
/solar: C15.1, C16.1, L2.1, P1.1, R44.1
/solar+: P14.2 (PM), R16.1, R18.1, R20.1, R22.1, R24.1, R28.1
/solar-volt: R44.2, R45.1, stm1.15 (PA5/SPI1_SCK/ADC_IN5)
/swd-clk: P6.1, stm1.37 (JTCK/SWCLK^PA14)
/swd-io: P7.1, stm1.34 (JTMS/SWDIO^PA13)
/temperature: TC1.2 (Vout), stm1.18 (PB0/ADC_IN8/TIM3_CH3)
/tx: K1.1, stm1.30 (PA9/USART1_TX)
/usb-connected: R67.2, stm1.29 (PA8/USART1_CK/MCO)
/wakeup: R71.2, stm1.19 (PB1/ADC_IN9/TIM3_CH4)
GND: C1.2, C2.2, C3.2, C4.2, C5.2, C6.1, C7.1, C8.1, C9.2, C11.2, C13.2, C14.2, C15.2, C16.2, C17.2, C18.2, C19.2, C20.2, C21.2, C22.2, C23.2, C24.2, C26.2, C27.2, D1.2 (K), D2.2 (K), D3.1 (A), D4.4 (V-), D5.1 (A), K1.3, P1.2 (PM), P2.2 (PM), P3.4, P4.4, P4.5, P5.2 (PM), P8.1, P9.6, P12.2 (PM), Q1.1 (E), Q3.1 (E), Q6.3 (C), Q8.3 (C), Q9.1 (E), Q10.S, Q13.S, R10.2, R12.2, R13.2, R29.1, R30.1, R32.1, R36.1, R37.1, R42.1, R45.2, R47.2, R48.1, R55.1, R56.2, R68.1, R70.2, TC1.3 (Vss), U1.4 (gnd), U2.4 (gnd), U2.5 (gnd), U2.6 (gnd), U2.7 (gnd), U2.14 (gnd), U2.15 (gnd), U2.16 (gnd), U2.17 (gnd), U3.0 (Shell), U3.5 (Gnd), lsm1.7 (GND), lsm1.10 (Reserved_to_gnd), lsm1.11 (Reserved_to_gnd), stm1.8 (Vssa), stm1.23 (Vss_1), stm1.35 (Vss_2), stm1.47 (Vss_3)
unnamed: Q4.D, U2.10 (vs), U2.20 (vss)
unnamed: Q12.G, R61.2
unnamed: Q1.2 (B), R49.2
unnamed: Q4.G, R53.2
unnamed: Q5.1 (E), Q6.1 (E), R60.1
unnamed: Q3.3 (C), Q5.2 (B), Q6.2 (B), R54.2
unnamed: D5.2 (K), L3.1, Q11.D, Q14.D
unnamed: Q2.1 (E), Q7.2 (B), Q8.2 (B), R56.1
unnamed: Q2.2 (B), R50.1
unnamed: R35.1, R36.2
unnamed: R33.1, R34.2
unnamed: R65.2, U3.2 (D-)
unnamed: R68.2, U3.4 (Id)
unnamed: R66.2, R67.1, U3.3 (D+)
unnamed: R10.1, R11.1, U1.5 (comp)
unnamed: R1.1, R3.1, R6.1, U1.1 (swc), U1.7 (ipk)
unnamed: C3.1, U1.3 (tcap)
unnamed: C8.2, R15.2, stm1.7 (NRST)
unnamed: R12.1, stm1.44 (BOOT0)
unnamed: C6.2, X1.2, stm1.5 (PD0/OSC_IN)
unnamed: R14.2, stm1.6 (PD1/OSC_OUT)
unnamed: R13.1, stm1.20 (PB2/BOOT1)
unnamed: C7.2, R14.1, X1.1
unnamed: Q7.1 (E), Q8.1 (E), R59.1
unnamed: Q3.2 (B), R51.1
unnamed: D2.1 (A), R8.2
unnamed: D1.1 (A), R2.2
unnamed: D3.2 (K), L1.1, U1.2 (swe)
unnamed: P4.1, R71.1
unnamed: C25.1, lsm1.12 (SETP)
unnamed: P14.1, U3.1 (VBus)
unnamed: Q11.G, Q14.G, R60.2
unnamed: Q10.G, Q13.G, R59.2
unnamed: D6.1 (A), L2.2, Q10.D, Q13.D
unnamed: C24.1, lsm1.6 (C1)
unnamed: C25.2, lsm1.13 (SETC)
unnamed: R41.1, R42.2
unnamed: R39.1, R40.2
unnamed: Q1.3 (C), R52.2, R53.1
unnamed: P12.1, R62.2, R63.2, R64.2
unnamed: Q9.3 (C), R58.1, R61.1
unnamed: Q9.2 (B), R57.2
unnamed: Q12.D, R62.1, R63.1, R64.1
VDD: C4.1, C5.1, C9.1, C11.1, C13.1, C14.1, C23.1, C26.1, C27.1, D4.8 (V+), L1.2, P3.3, P4.6, P4.7, Q2.3 (C), Q7.3 (C), R4.1, R5.2, R7.1, R11.2, R15.1, R33.2, R39.2, TC1.1 (Vdd), lsm1.1 (Vdd_IO), lsm1.14 (Vdd), stm1.1 (Vbat), stm1.9 (Vdda), stm1.24 (Vdd_1), stm1.36 (Vdd_2), stm1.48 (Vdd_3)

Notes on the sheet:
3.3V buck scheme for powering MCU.
Powerful buck scheme for 5V generation.
Boost scheme for accumulator charging.
Chassis motors control cheme.
Indicator LEDs for debugging.
Powerful LED on/off.
Jumper here tells MCU to never turn 5V converter off.
Analog temperature sensor
No pullups here as there are on raspberry-pi.
Power source such as solar panel. It's voltage shouldn't be greater then battery's voltage. It is because battery is changed using boost scheme.
Battery connection socket.
Programming socket is planned to be made of individual pads. And programming cable is supposed to be attached with crocodile clip.
Cross board communication socket. There is one at this board. But there should be two neighbour such sockets on all other boards to be able to stack them together.
Two unconnected pins for screws. The newest Raspberry Pi contains holes for M3 screws.
Socket for powering external devices.
Optionally could be USB powered through "solar+". It is because of ability to control current through "solar+".
This capacitor gives cutoff frequency at about 170kHz.
And four for screws at board corners.
Pin 1 is for waking up all other boards.

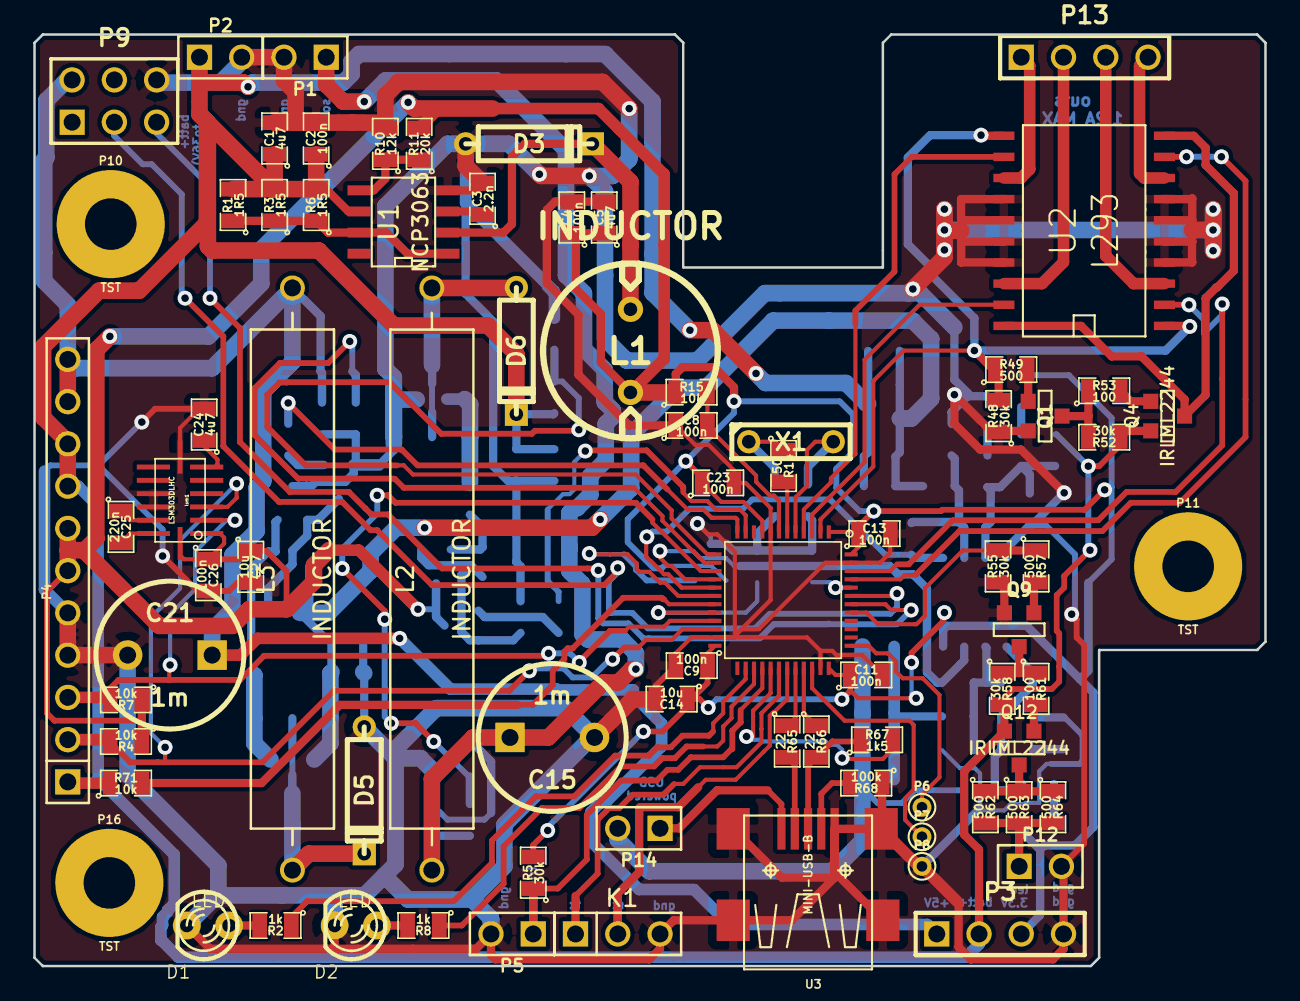
[picture p31: board supply-board.kicad_pcb from above]

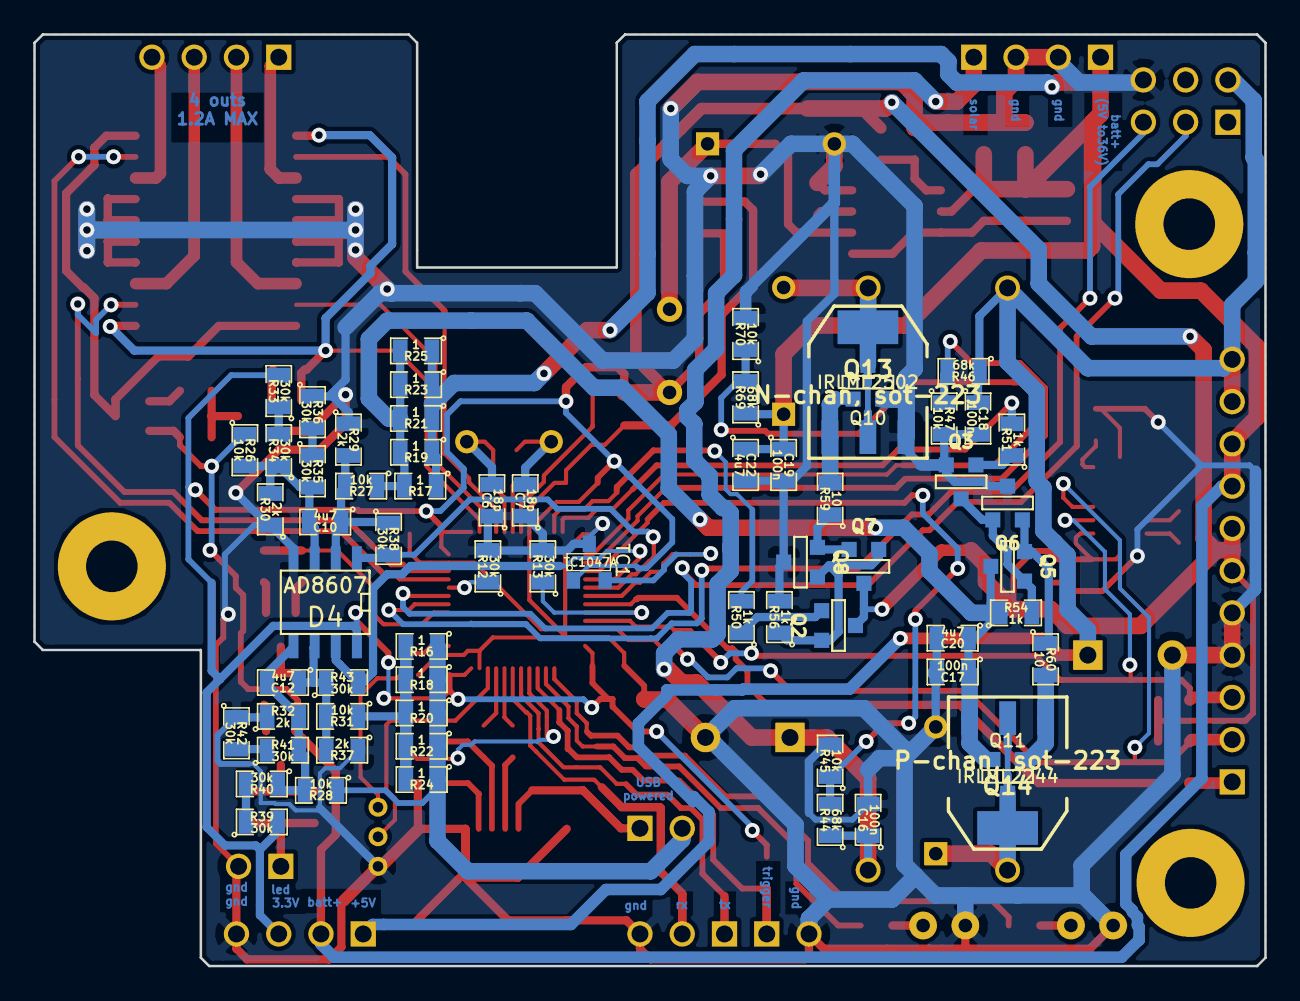
[picture p32: board supply-board.kicad_pcb from below]

Board: 2 copper layers, 74.0 x 56.0 mm, 143 parts (64 on the bottom side), 88 nets.
