z80/supply/main-board-2/firmware/firmware/src/serial_ctrl.h

#ifndef __SERIAL_CTRL_H_
#define __SERIAL_CTRL_H_

#include "ch.h"

void setSerialEn( uint8_t en, int newBaud );
int  serialSend( uint8_t * data, int sz );
int  serialReceive( uint8_t * data, int maxSz );


#endif
