z80/supply/main-board/firmware/dfu/src/hw_config.c

/******************** (C) COPYRIGHT 2011 STMicroelectronics ********************
* File Name          : hw_config.c
* Author             : MCD Application Team
* Version            : V3.3.0
* Date               : 21-March-2011
* Description        : Hardware Configuration & Setup
********************************************************************************
* THE PRESENT FIRMWARE WHICH IS FOR GUIDANCE ONLY AIMS AT PROVIDING CUSTOMERS
* WITH CODING INFORMATION REGARDING THEIR PRODUCTS IN ORDER FOR THEM TO SAVE TIME.
* AS A RESULT, STMICROELECTRONICS SHALL NOT BE HELD LIABLE FOR ANY DIRECT,
* INDIRECT OR CONSEQUENTIAL DAMAGES WITH RESPECT TO ANY CLAIMS ARISING FROM THE
* CONTENT OF SUCH FIRMWARE AND/OR THE USE MADE BY CUSTOMERS OF THE CODING
* INFORMATION CONTAINED HEREIN IN CONNECTION WITH THEIR PRODUCTS.
*******************************************************************************/

/* Includes ------------------------------------------------------------------*/
 #include "stm32f10x.h"

#include "hw_config.h"
#include "dfu_mal.h"
#include "usb_lib.h"
#include "usb_desc.h"
#include "platform_config.h"
#include "usb_pwr.h"

ErrorStatus HSEStartUpStatus;

static void IntToUnicode (uint32_t value , uint8_t *pbuf , uint8_t len);
/* Private functions ---------------------------------------------------------*/
/*******************************************************************************
* Function Name  : Set_System.
* Description    : Configures Main system clocks & power.
* Input          : None.
* Output         : None.
* Return         : None.
*******************************************************************************/
void Set_System(void)
{
  /*!< At this stage the microcontroller clock setting is already configured, 
       this is done through SystemInit() function which is called from startup
       file (startup_stm32f10x_xx.s) before to branch to application main.
       To reconfigure the default setting of SystemInit() function, refer to
       system_stm32f10x.c file
     */ 
  
  /* Unlock the internal flash */
  FLASH_Unlock();
 
  /* Init the media interface */
  MAL_Init();
}

/*******************************************************************************
* Function Name  : Set_USBClock.
* Description    : Configures USB Clock input (48MHz).
* Input          : None.
* Output         : None.
* Return         : None.
*******************************************************************************/
void Set_USBClock(void)
{
  /* Select USBCLK source */
  RCC_USBCLKConfig(RCC_USBCLKSource_PLLCLK_Div1);
  
  /* Enable the USB clock */
  RCC_APB1PeriphClockCmd(RCC_APB1Periph_USB, ENABLE);
}

/*******************************************************************************
* Function Name  : Enter_LowPowerMode.
* Description    : Power-off system clocks and power while entering suspend mode.
* Input          : None.
* Output         : None.
* Return         : None.
*******************************************************************************/
void Enter_LowPowerMode(void)
{
  /* Set the device state to suspend */
  bDeviceState = SUSPENDED;
}

/*******************************************************************************
* Function Name  : Leave_LowPowerMode.
* Description    : Restores system clocks and power while exiting suspend mode.
* Input          : None.
* Output         : None.
* Return         : None.
*******************************************************************************/
void Leave_LowPowerMode(void)
{
  DEVICE_INFO *pInfo = &Device_Info;

  /* Set the device state to the correct state */
  if (pInfo->Current_Configuration != 0)
  {
    /* Device configured */
    bDeviceState = CONFIGURED;
  }
  else
  {
    bDeviceState = ATTACHED;
  }
}

/*******************************************************************************
* Function Name  : USB_Cable_Config.
* Description    : Software Connection/Disconnection of USB Cable.
* Input          : NewState: new state.
* Output         : None.
* Return         : None.
*******************************************************************************/
void USB_Cable_Config (FunctionalState NewState)
{
  if ( NewState == ENABLE )
  {
      RCC_APB2PeriphClockCmd( RCC_APB2Periph_GPIOB, ENABLE );
      GPIO_InitTypeDef s;
      s.GPIO_Pin = GPIO_Pin_15;
      s.GPIO_Mode = GPIO_Mode_Out_PP;
      s.GPIO_Speed = GPIO_Speed_10MHz;
      GPIO_Init( GPIOB, &s );
      GPIO_SetBits( GPIOB, GPIO_Pin_15 );
  }
  else
  {
      GPIO_InitTypeDef s;
      s.GPIO_Pin = GPIO_Pin_15;
      s.GPIO_Mode = GPIO_Mode_Out_PP;
      s.GPIO_Speed = GPIO_Speed_10MHz;
      GPIO_Init( GPIOB, &s );
      GPIO_ResetBits( GPIOB, GPIO_Pin_15 );
      RCC_APB2PeriphClockCmd( RCC_APB2Periph_GPIOB, DISABLE );
  }
}


/*******************************************************************************
* Function Name  : DFU_Button_Config.
* Description    : Configures the DFU selector Button to enter DFU Mode.
* Input          : None.
* Output         : None.
* Return         : None.
*******************************************************************************/
void DFU_Button_Config(void)
{  
  /* Configure "DFU enter" button */
  //STM_EVAL_PBInit(Button_KEY, Mode_GPIO);

  RCC_APB2PeriphClockCmd( RCC_APB2Periph_GPIOA, ENABLE );
  GPIO_InitTypeDef s;
  s.GPIO_Pin = GPIO_Pin_8;
  s.GPIO_Mode = GPIO_Mode_IN_FLOATING;
  s.GPIO_Speed = GPIO_Speed_10MHz;
  GPIO_Init( GPIOB, &s );
}

/*******************************************************************************
* Function Name  : DFU_Button_Read.
* Description    : Reads the DFU selector Button to enter DFU Mode.
* Input          : None.
* Output         : None.
* Return         : Status
*******************************************************************************/
uint8_t DFU_Button_Read (void)
{
  if ( GPIO_ReadInputDataBit( GPIOA, GPIO_Pin_8 ) != Bit_RESET )
      return 0;
  return 1;

}

/*******************************************************************************
* Function Name  : USB_Interrupts_Config.
* Description    : Configures the USB interrupts.
* Input          : None.
* Output         : None.
* Return         : None.
*******************************************************************************/
void USB_Interrupts_Config(void)
{
  NVIC_InitTypeDef NVIC_InitStructure;

  NVIC_InitStructure.NVIC_IRQChannel = USB_LP_CAN1_RX0_IRQn;
  NVIC_InitStructure.NVIC_IRQChannelPreemptionPriority = 0;
  NVIC_InitStructure.NVIC_IRQChannelSubPriority = 0;
  NVIC_InitStructure.NVIC_IRQChannelCmd = ENABLE;
  NVIC_Init(&NVIC_InitStructure);
}

/*******************************************************************************
* Function Name  : Reset_Device.
* Description    : Reset the device.
* Input          : None.
* Output         : None.
* Return         : None.
*******************************************************************************/
void Reset_Device(void)
{
  //USB_Cable_Config(DISABLE);
  NVIC_SystemReset();
}

/*******************************************************************************
* Function Name  : Get_SerialNum.
* Description    : Create the serial number string descriptor.
* Input          : None.
* Output         : None.
* Return         : None.
*******************************************************************************/
void Get_SerialNum(void)
{
  uint32_t Device_Serial0, Device_Serial1, Device_Serial2;

  Device_Serial0 = *(__IO uint32_t*)(0x1FFFF7E8);
  Device_Serial1 = *(__IO uint32_t*)(0x1FFFF7EC);
  Device_Serial2 = *(__IO uint32_t*)(0x1FFFF7F0);

  Device_Serial0 += Device_Serial2;

  if (Device_Serial0 != 0)
  {
    IntToUnicode (Device_Serial0, &DFU_StringSerial[2] , 8);
    IntToUnicode (Device_Serial1, &DFU_StringSerial[18], 4);
  }
}

/*******************************************************************************
* Function Name  : HexToChar.
* Description    : Convert Hex 32Bits value into char.
* Input          : None.
* Output         : None.
* Return         : None.
*******************************************************************************/
static void IntToUnicode (uint32_t value , uint8_t *pbuf , uint8_t len)
{
  uint8_t idx = 0;
  
  for( idx = 0 ; idx < len ; idx ++)
  {
    if( ((value >> 28)) < 0xA )
    {
      pbuf[ 2* idx] = (value >> 28) + '0';
    }
    else
    {
      pbuf[2* idx] = (value >> 28) + 'A' - 10; 
    }
    
    value = value << 4;
    
    pbuf[ 2* idx + 1] = 0;
  }
}
