z80/supply/(commit log)

2013-08-16 Started schematics.
    [current_sensor.sch, supply-board.sch]
2013-08-17 Board scheme development...
    [supply-board.sch]
2013-08-19 More or less finished schema.
    [supply-board.sch]
2013-08-20 Started placing components.
    [supply-board.kicad_pcb, supply-board.sch]
2013-08-21 Made footprints for components I didn't have footprints. And started placing components.
    [supply-board.sch]
2013-08-23 Placing components...
    [supply-board.kicad_pcb]
2013-08-24 Placing elements.
    [supply-board.kicad_pcb, supply-board.sch]
2013-08-25 Places all but current measure circuit.
    [supply-board.kicad_pcb]
2013-08-26 Composed current measure circuit outside of the board.
    [$supply-board.sch, supply-board.kicad_pcb]
2013-08-26 Changed USB power from "batt+" to "solar+".
    [$supply-board.sch, supply-board.kicad_pcb, supply-board.sch]
2013-08-30 Routing and changing netlist to make routing more convenient.
    [supply-board.kicad_pcb, supply-board.sch]
2013-08-31 Routing is done. Added GND zones. I'm going to add text right in copper layer.
    [supply-board.kicad_pcb]
2013-08-31 Added socket labels.
    [supply-board.kicad_pcb]
2013-08-31 Added acelerometer (it's optional).
    [supply-board.kicad_pcb, supply-board.sch]
2013-08-31 Started extension board.
    [addon-board.sch]
2013-09-02 Added shift registers to increase IO pins number.
    [addon-board.kicad_pcb, addon-board.sch]
2013-09-04 Placing components.
    [addon-board.kicad_pcb]
2013-09-06 Started routing.
    [addon-board.kicad_pcb, addon-board.sch, power_up_calc.sch]
2013-09-07 Finished routing. Holes for supports and cross board socket matches should be checked!
    [addon-board.kicad_pcb, addon-board.sch]
2013-09-07 Added more ground viases.
    [addon-board.kicad_pcb]
2013-09-09 Moved peripherial sockets closer to outer board edge.
    [addon-board.kicad_pcb, supply-board.kicad_pcb]
2013-09-10 Started composing BOT for purchasing.
    [bom.ods]
2013-09-10 Raplaced power mosfets with sot23 transistors because of their max current and very low resistance.
    [addon-board.kicad_pcb, addon-board.sch, bom.ods, supply-board.kicad_pcb, supply-board.sch]
2013-09-10 For boost and buck circuits made optional sot23/sot223 transistor packages.
    [supply-board.kicad_pcb, supply-board.sch]
2013-09-11 Shifted all RF origins to board corner. Generated gerber and drill files.
    [addon-board.kicad_pcb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]
2013-09-11 DFU firmware. Pins adjusted for supply board.
2013-09-11 Firmware is copied from DFU repository.
    [cosmic.stp, raisonance.stp]
2013-09-11 Editing board.h to match current board.
2013-09-14 Voltage converter processing.
2013-09-15 Implemented LED and Motor control files.
2013-09-16 Minimized thread switch time. Made threads cooperative.
2013-09-20 Fixed DFU button processing.
    [hw_config.c, main.c]
2013-09-22 In such a way it works. But when I insert chThdSleepMilliseconds() function it hangs up at the location of the very first entry of that function.
2013-09-22 LED and Light work.
2013-09-22 Fixed ADC signal indices. Buck works.
    [conv_ctrl.c, hdw_cfg.h, main.c]
2013-09-23 Filling Pawn binding functions.
    [halconf.h, hdw_cfg.h, mcuconf.h, pawn_binding.c, pawn_binding.h, pawn_ctrl.c, serial_ctrl.c, serial_ctrl.h]
2013-09-23 Project compiles with I2C support inserted.
2013-09-23 Implemented ADC Pawn functions.
2013-09-25 Fixed USB connect/disconnect pin.
2013-09-25 Investigating the root of a problem why USB device presents but nothing coul'd be written here. At this line it works.
    [main.c, mcu_ctrl.cpp, pawn_config.h]
2013-09-29 Fixed setIo() and io() functions in usbctrl library. These functions work properly. But io() worsk very slowly(!!!).
    [main.cpp, mcu_ctrl.cpp]
2013-09-29 Fixed DFU USB on/off functionality.
    [hw_config.c, main.c]
2013-09-30 In DFU mode start there was wrong jump address. After fixing DFU firmware starts properly. At list it is shown in "lsusb" output.
    [hdw_cfg.h]
2013-09-30 I2C test failed. Probably it is because accelerometer is not soldered well.
    [main.cpp]
2013-09-30 Fixed temperature measure. Implemented temperature measure test.
    [conv_ctrl.c]
2013-10-01 Debugging: changing Pawn thread stack size and virtual machine memory size.
2013-10-01 Fixed I2C IO function.
    [pawn_binding.c]
2013-10-03 Started addon-board firmware design.
    [cosmic.stp, raisonance.stp]
2013-10-04 Made project compilable. Commented out all but testing LEDs.
2013-10-05 Found schematic problem: +6V and batt+ circuits are not connected.
2013-10-05 Led and Moto controls work properly.
2013-10-05 PWM doesn't work at all. Any PWM enable channel causes failure.
    [main.c, pwm_ctrl.c]
2013-10-05 If anything related to PWM is uncommented CPU jumps to unhandled exception.
2013-10-05 Standard PWM HAL test works.
2013-10-05 Still doesn't die.
2013-10-05 PWM initialization works.
2013-10-05 It seems ADC works as well. Default value is about 340.
2013-10-05 Sleep and wakeup controls initialize without crashes.
    [main.c]
2013-10-05 I2C initialization passed.
2013-10-06 Added "setWakeup(arg)" function to supply board firmware.
2013-10-06 LEDs test for addon board works. It meand I2C communication works as well.
2013-10-07 Implemented voltage, temperature and current conversion formulas.
2013-10-07 Maximum current test. It seems it is failed. Current is 4 times greater then expected and a bit less then V/R. Current set was 100mA, obtained - 340mA, V/R = 2000/3 = 666.7mA.
2013-10-08 Turned size optimization on for addon board firmware.
2013-10-08 Circle LEDs. And it works.
2013-10-08 Decreased ADC period.
2013-10-08 Current limit test script. It seems it works and multimeter just shows wrong value because current changes over time significantly.
2013-10-08 Worked with install directories structure. Added prototype for python USB module.
2013-10-08 Renamings and added I2C module.
2013-10-11 Fixed a couple of bugs in GUI.
2013-10-13 Board documentation is started.
2013-10-14 Filled funcs related to PWM.
2013-10-15 Scripts proceeds if trigger button is pressed.
2013-10-15 Servo control works. Period 20ms, duty cycle from 1ms to 2ms.
2013-10-15 Works with Raspberry Pi powering.
2013-10-16 Fixed python test script.
    [io_test.py]
2013-10-16 Improved servo from python control test.
2013-10-21 Rotating camera example. Sources for Python.
2013-10-21 Forgotten to add i2c test.
2013-10-21 Two servos control with RPC works!
2013-10-22 Seems ADC and input functions work. For ADC function it was an error in result return. It was written in worng place. Now it is fixed.
    [i2c_ctrl.c]
2013-10-22 Input and ADC test works. Or at least it looks so.
2013-10-25 Board interaction description file.
2013-10-25 Windows driver.
2013-10-27 Inserted the same to robot script.
2013-10-29 Separate current limiting circuit.
    [curlim.kicad_pcb, curlim.sch]
2013-11-16 Commented about upper voltage dividing resistor.
    [curlim.sch]
2013-12-06 Made scheme for main-board-2.
    [main-board-2.sch]
2013-12-07 Optimizing board...
    [main-board-2.kicad_pcb, main-board-2.sch]
2013-12-07 Assigned components to footprints.
    [main-board-2.sch]
2013-12-08 Placing elements...
    [main-board-2.kicad_pcb, main-board-2.sch]
2013-12-08 Removed unused screw holes.
    [main-board-2.kicad_pcb, main-board-2.sch]
2013-12-09 Routing. Made servo power switchable.
    [main-board-2.kicad_pcb, main-board-2.sch]
2013-12-09 Routing rx and tx...
    [main-board-2.kicad_pcb, main-board-2.sch]
2013-12-10 Routing. It turnes out it is very nontrivial to route with horizontal TO-220. I'm going to change to vertical TO-220.
    [main-board-2.kicad_pcb, main-board-2.sch]
2013-12-10 Changed packages to vertical ones.
    [main-board-2.kicad_pcb]
2013-12-11 Just one more circuit Vdd to addon socket last.
    [main-board-2.kicad_pcb, main-board-2.sch]
2013-12-11 Just connected all unconnected circuits.
    [main-board-2.kicad_pcb]
2013-12-11 Added comments.
    [main-board-2.kicad_pcb]
2013-12-12 Places zones and made thermal take zones under regulators.
    [$main-board-2.sch, main-board-2.kicad_pcb]
2013-12-12 Displaced TO-220 regulators.
    [main-board-2.kicad_pcb]
2013-12-12 Forgot to save scheme.
    [$main-board-2.sch, main-board-2.csv, main-board-2.sch]
2013-12-12 Little improvements.
    [main-board-2.kicad_pcb]
2013-12-12 Changed paintings.
    [main-board-2.kicad_pcb]
2013-12-12 Made Vdd wire to MCU a bit wider.
    [main-board-2.kicad_pcb]
2013-12-12 Firmware folder is copied to main-board-2 folder.
    [cosmic.stp, raisonance.stp]
2013-12-12 Reverted user button processing in DFU firmware.
    [main.c]
2013-12-12 Adjusted pads and ports to the new board.
2013-12-13 Implemented PWM using Timer callback.
2013-12-14 Changed contacts locations on power source selection sockets.
    [main-board-2.kicad_pcb, main-board-2.sch]
2013-12-15 Exported gerber files.
    [main-board-2.kicad_pcb]
2013-12-15 Fixed some issues in gpio control module.
    [gpio_ctrl.c]
2013-12-15 Made power switching automatic for both pwm and moto.
2013-12-21 Placed elements on addon board with gpio.
    [addon-gpio.kicad_pcb, addon-gpio.sch]
2013-12-23 Routed. Making silcography.
    [addon-gpio.kicad_pcb]
2013-12-23 Made drawing with connections scheme.
    [addon-gpio.kicad_pcb]
2013-12-23 Added small accelerometer module.
    [addon-acc.kicad_pcb, addon-acc.sch]
2014-01-11 Added addon board description.
2014-02-11 Found unnecessary conversion from ADC to temperature.
